fablab-bergamo/Fab-O-matic/hardware/README.md

# HARDWARE information (PCB, Enclosures)

This folder contains info about PCB (Gerber file, BOM, schematics) and enclosures.

## PCB versions

* Project has been sponsored by EasyEDA in the OpenHWLab [Project homepage](https://oshwlab.com/pascal.brunot/rfid-arduino-fablab-bg-v2_2024-04-01_14-22-11)
* For more information, a series of articles regarding the HW & PCB design have been published on our FabLab website (Italian language 🇮🇹)

> [Breadboarding](https://www.fablabbergamo.it/2024/06/03/fabomatic1/)
>
> [Modules and Box](https://www.fablabbergamo.it/2024/06/09/fabomatic2/)
>
> [PCB](https://www.fablabbergamo.it/2024/06/16/fabomatic3/)
>
> [Electrical schema](https://www.fablabbergamo.it/2024/06/23/fabomatic4/)
>
> [PCB-A and costs](https://www.fablabbergamo.it/2024/06/30/fabomatic5/)

### Revision 1.3

Changes from rev 1.2:

* Design is now robust for Mains voltage on PCB for machine control (large PCB copper tracks, isolation gaps > 4 mm, PCB cutout)
* Added D9 to protect USB from incorrect power flow to machine and host.
* 2 independent terminal blocks for machine control and board power
* Layout and routing changed, but ESP32/RFID/LCD/factory default button/Neopixel have not been moved.

⚠ Errata in this revision ⚠

* None known.

### Revision 1.2

Changes from rev 1.1:

* Added D7 and D8 for reverse voltage protection on 5V and POW+ external pins, also they prevent incorrect power flow to machine and host.
* Removed (wrong) over-voltage protection Zener diodes.
* Terminal block pin 8 is now left unconnected (previously, it was an output 3V3).
* Added R13/R14/R15 to tolerate 5V input if R16 is removed.
* (Color PCB) Added small vias on color PCB to allow the NeoPixel light to filter through.

⚠ Errata in this revision ⚠

* PCB design is not MAINS AC safe (see NC/NO/COM tracks: width, spacing and area copper plane & signal tracks).
* Any high current will BURN the COM/NO PCB tracks on the PCB from the terminal blocks to the relay. As a workaround, solder wires between terminal blocks and relay pins on the PCB !

### Revision 1.1

Changes from rev 1.0:

* Fixed buck converter R11 connection to FB pin instead of 5V.
* Fixed Q1 footprint (switched model)
* Buzzer is now on top side as it makes enough noise and it can be assembled by JLCPCB this way.
* Slight layout changes (moved connector down, protection components done, increased distance between relay and command components)

⚠ Errata in this revision ⚠

* PCB design is not MAINS AC safe (NC/NO/COM tracks to the relay).
* Any high current will BURN the COM/NO PCB tracks on the PCB from the terminal blocks to the relay. As a workaround, solder wires between terminal blocks and relay pins on the PCB !
* Power can flow from the machine to the host through the USB port. A diode needs to be added.
* Power can flow from the host to the machine through the USB port. A diode needs to be added.
* The color PCB front panel is missing a soldermask expansion to let the NeoPixel light filter through the white silkscreen. A small spot of silkscreen can easily be removed with a Dremel as fix.
* Reverse/under voltage protection circuit is wrong.

### Revision 1.0

This version is easy to order as pre-assembled on JLCPCB. For 10 boards, total cost (as per April 2024) is below 200 EUR total (not considering modules and boxes). Soldering map is available is you want to assemble yourself : <code>rev 1.0/soldering_map.html</code>

⚠ Errata in this revision ⚠

* PCB design is not MAINS AC safe (NC/NO/COM tracks to the relay).
* Any high current will BURN the COM/NO PCB tracks on the PCB from the terminal blocks to the relay. As a workaround, solder wires between terminal blocks and relay pins on the PCB !

* Q1 had wrong footprint, B and E pins are swapped. As a result, relay is not operative.

To fix: desolder Q1 and resolder it upside down with a good amount of soldering tin.

* Buck converter is delivering 0.8V instead of 5V due to schematic error.

To fix: R11 shall be connected between GND and FB pin, because FB shall be the center of the voltage divider. In this version, R11 was connected between GND and 5V.
This can be fixed by rotating R11 by 90° counter-clockwise and solder it to R9.

* The RFID pin labels printed on bottom side are wrong (text only issue).



* The color PCB front panel is missing a soldermask expansion to let the NeoPixel light filter through the white silkscreen. A spot of silkscreen can easily be removed with a Dremel.
* Power can flow from the machine to the host through the USB port. A diode needs to be added.
* Power can flow from the host to the machine through the USB port. A diode needs to be added.
* Reverse/under voltage protection circuit is wrong.

Changes from rev 0.4:

* Added an integrated a buck converter for 5V generation instead of a module
* Replaced USB B port with a USB C
* SMD components wherever possible (Q1, USB, variable resistor, buttons)
* Components update based on [https://github.com/yaqwsx/jlcparts] availabilities
* ESP32-S3-WROOM-1-N4R8 selected for availability (N4 was enough).
* More compact board design
* Added a color printer PCB front panel design + layout adjustments to accomodate front panel design

### Revision 0.4

Changes:

* Fixed errata of revision 0.3
* Removed 220u CAP after testing, it is not required.
* Moved the design to EASYEDA Pro (free) for future versions

⚠ Errata in this revision ⚠

* PCB design is problably not MAINS AC safe (NC/NO/COM tracks to the relay).
* Power can flow from the machine 5V to the host through the USB port. A diode needs to be added.
* Power can flow from the host to the machine 5V through the USB port. A diode needs to be added.

### Assembly instructions

An interactive PCB map is available under <code>rev 0.4/soldering_map.html</code>

Order is important:

1. (front side) Solder ESP32S3-WROOM-1 module. Check for shorts.
2. (front side) Solder all others SMD components
3. (front side) Solder through-hole components (terminal blocks, relay, Q1, USB, capacitor)
4. (reverse side) Solder NeoPixel, 3V buzzer, female pins for RFID / LCD modules, defaults switch.

Test procedure

1. Continuity check : power lines (3V3, 5V) to ESP32, LDO, LCD/RFID modules.
2. Terminal blocks: NC and COM shall be continuous. NO and COM shall not be continuous.
3. Check for shorts between 5V and - ; 3V3 and - ; + and - pins (there should not be any)
4. Connect +5V to the 5V terminal block and GND to - terminal block
5. Check that voltage on 3V3 pin is 3.3V
6. Disconnect external power.
7. Connect USB cable to PC
8. Check voltages on 5V and 3V3 pins
9. Push BOOT, Push RESET, Release RESET, release BOOT
10. ESP32S3 shall be recognized on PC as a serial port

💡 A fresh ESP32-S3 will be in a reboot cycle before the first flash. It is normal to have the USB connect/disconnect sounds at this stage.

11. Upload software with PlatformIO
12. Disconnect USB
13. Connect modules (including buck converter if needed)
14. Connect USB
15. Open Monitor and check for errors.

### Revision 0.3

⚠ Errata in this revision ⚠

* PCB design is problably not MAINS AC safe (NC/NO/COM tracks to the relay).
* Q1 base shall be pulled up by a 5-10kohm resistor to 3V3 to avoid relay flickering at boot (while ESP32 has not pulled up the pin yet).

Changes:

* fixed errata of REV 0.2 (2N3906 for through hole/smd + RW pin)
* smaller footprints for capacitors
* added component values on silkscreen
* slight repositioning of RFID module to avoid overlap with default switch
* added 220 uF capacitor on 5V rail for LCD
* removed terminal blocks IN+/OUT+ as there are enough connection ports on the board
* added input protections with Zener+resettable 100mA fuses.

Link to project: <https://oshwlab.com/pascal.brunot/rfid-arduino-fablab-bg_copy>

### Revision 0.2

Fully working with some issues requiring rework.

Assembled front:



Assembled back:



⚠ Errata in this revision ⚠

* Relay requires more current than ESP32 can provide. A PNP transistor can be soldered next to the terminal blocks to solve the problem. Connect Base on K pin, Emitter on 3V3 pin and Collector to coil (+). The track between CMD and Coil(+) passing below the relay must be cut. Relay takes 70 mA approx. The pin must be configured active_low.



* (NOT IN THE PHOTO) : a 10k resistor shall be added too between Base and 3V3 to avoid flickering at boot. Fixed in rev 0.4.

* Buzzer must be 3V3 low current. However common Arduino buzzers require 5V and high current. When using this model, the ESP32 resets due to voltage dropping. There are two solutions: use a 3 pin Arduino buzzer with VIN/GND/Signal (the PCB is compatible with such buzzers), or use a low current buzzer.

* LCD RW pin must be grounded (fix with soldering wire). Otherwise the LCD does not accept commands from ESP32.



Changes during assembly:

* Variable resistor for brightness adjustment replaced with 1k resistor
* C2 and C3 were not mounted because their pads were damaged during ESP32 soldering.
* Zener protection diode D7 and F1 not mounted (overvoltage protection)
* D4 replaced with a wire (reverse polarity protection) because voltage drop was too high (need 0.3V)

## 3D enclosures

## For hardware revision 1.x

* A Freecad project is provided in "enclosure for rev 1.x" folder. The finished 3D printed enclosure result is shown below:





* Enclosure concept



* How to print ?

2 STL files are provided (CASE and TAPPO) to import in your preferred slicer.

* How to assemble ?

4 screws, washer and bolts are required to fix the PCB to the case.

Assembly photos see <https://github.com/fablab-bergamo/Fab-O-matic/tree/b52aab18b81a9b51205c8e2c9dcc90458335382c/hardware/enclosure%20for%20rev%201.x/photos>
