fablab-bergamo/Fab-O-matic/hardware/enclosure for rev 1.x/freecad-case.gif

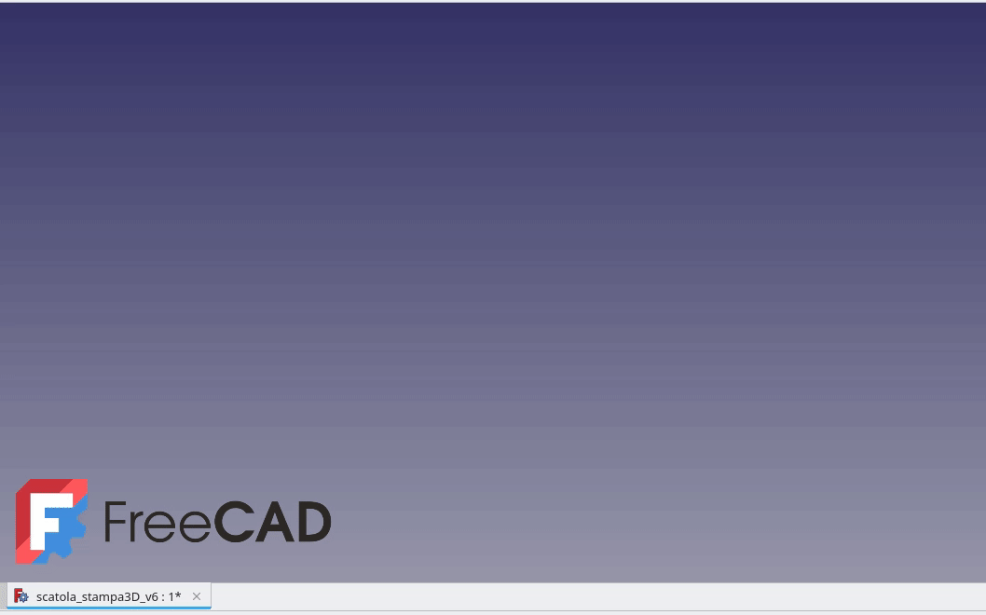
hardware/enclosure for rev 1.x/freecad-case.gif
