fablab-bergamo/Fab-O-matic/hardware/enclosure for rev 1.x/photos/IMG_20240713_195248.jpg

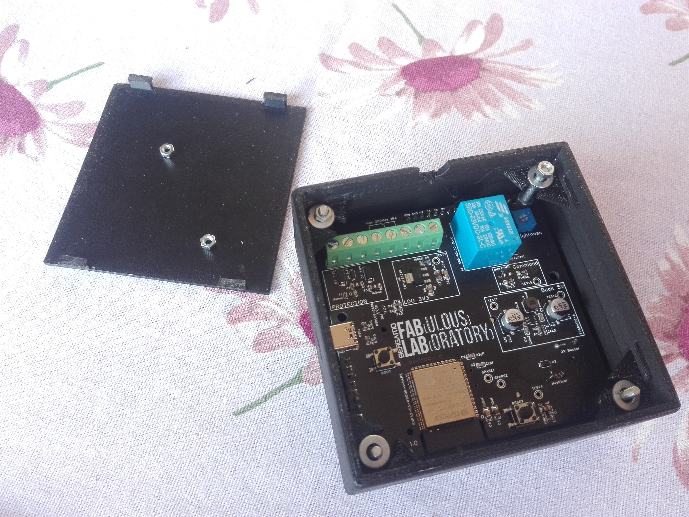
hardware/enclosure for rev 1.x/photos/IMG_20240713_195248.jpg
