fablab-bergamo/Fab-O-matic/hardware/rev 1.3/3D_PCB REV1.3_2024-08-18.png

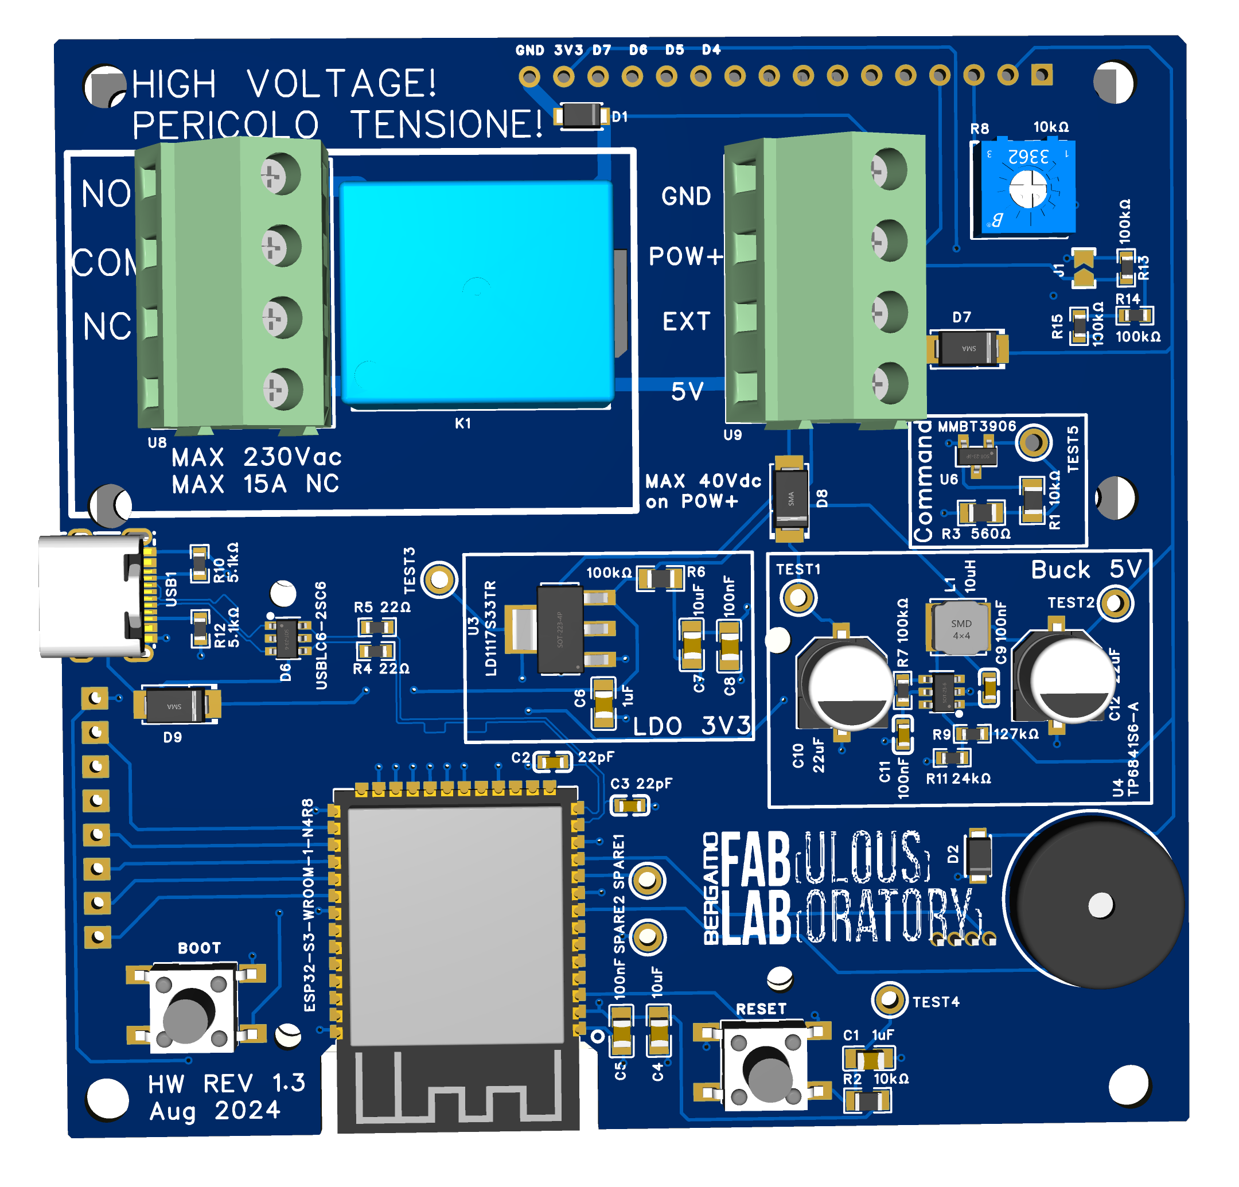
hardware/rev 1.3/3D_PCB REV1.3_2024-08-18.png
