fablab-bergamo/Fab-O-matic/hardware/rev 1.3/prices no shipping.png

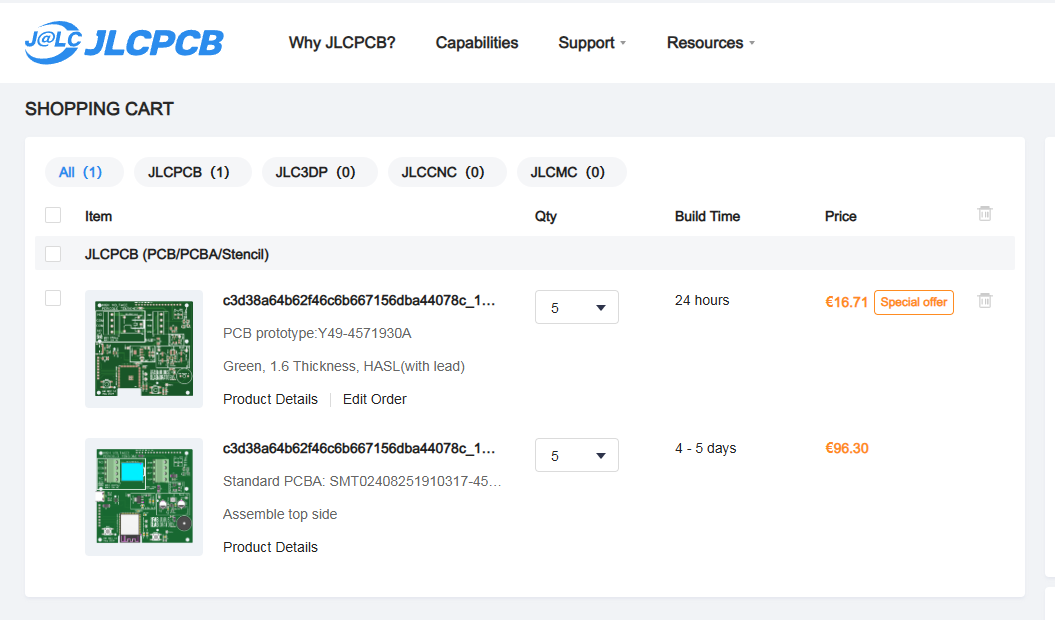
hardware/rev 1.3/prices no shipping.png
