fablab-bergamo/Fab-O-matic/hardware/rev 1.3/track width.png

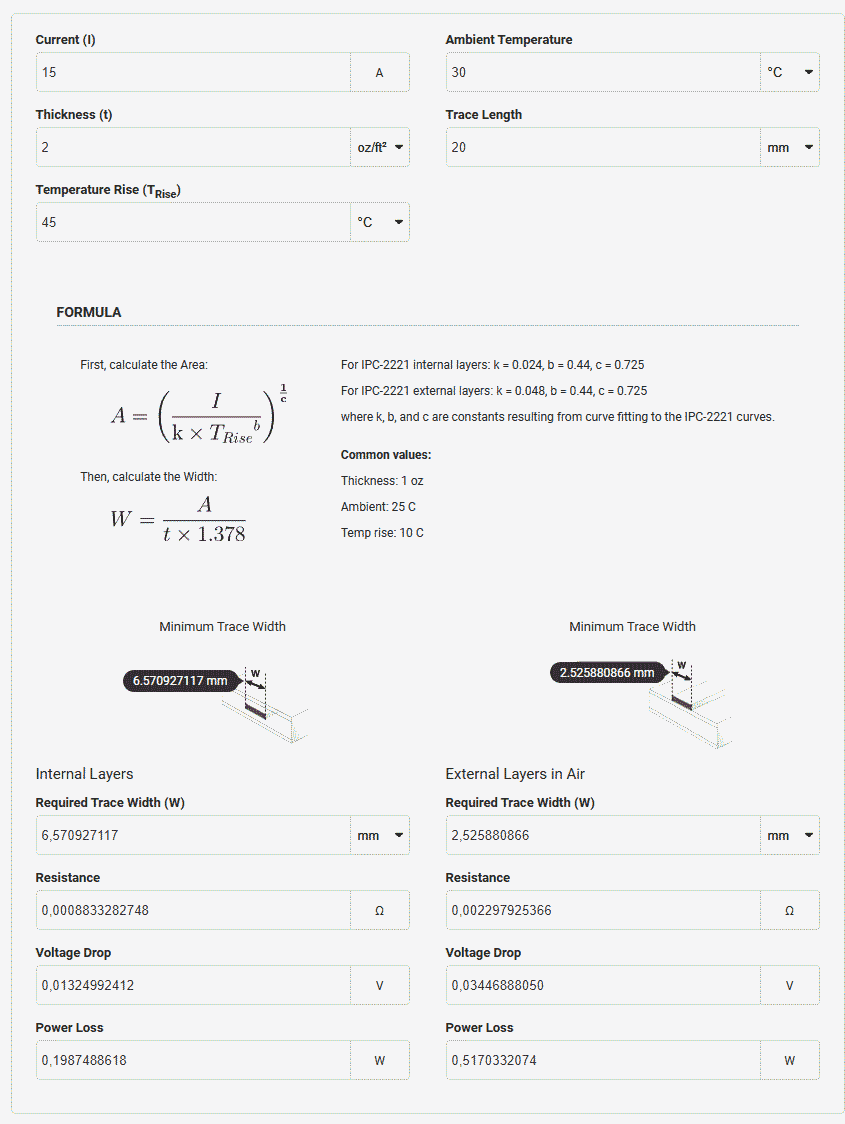
hardware/rev 1.3/track width.png
