fablab-bergamo/Fab-O-matic/hardware/rev 1.3/BOM_FAB-O-MATIC_PCB REV1.3_2024-08-18.xlsx

No. | Quantity | Comment | Designator | Footprint | Value | Manufacturer Part | Manufacturer | Supplier Part | Supplier
1 | 1 | 4kHz | BUZZER1 | BUZ-TH_BD12.5-P6.50-D0.9 | 4kHz | SFN-12055PA6.5 | S&S(海旭) | C360607 | LCSC
2 | 2 | 1uF | C1,C6 | C0805 | 1uF | CL21B105KBFNNNE | SAMSUNG(三星) | C28323 | LCSC
3 | 2 | 22pF | C2,C3 | C0603 | 22pF | CL10C220JB8NNNC | SAMSUNG(三星) | C1653 | LCSC
4 | 2 | 10uF | C4,C7 | C0805 | 10uF | GRM21BR61H106KE43L | muRata(村田) | C440198 | LCSC
5 | 2 | 100nF | C5,C8 | C0805 | 100nF | CL21B104KCFNNNE | SAMSUNG(三星) | C28233 | LCSC
6 | 2 | 100nF | C9,C11 | C0603 | 100nF | CC0603KRX7R9BB104 | YAGEO(国巨) | C14663 | LCSC
7 | 2 | 22uF | C10,C12 | CAP-SMD_BD6.3-L6.6-W6.6-FD | 22uF | RVT22UF50V67RV0028 | KNSCHA(科尼盛) | C2836438 | LCSC
8 | 2 | SM4007PL | D1,D2 | SOD-123F_L2.8-W1.8-LS3.7-RD |  | SM4007PL | MDD | C64898 | LCSC
9 | 1 | USBLC6-2SC6 | D6 | SOT-23-6_L2.9-W1.6-P0.95-LS2.8-BL |  | USBLC6-2SC6 | TECH PUBLIC(台舟) | C2827654 | LCSC
10 | 3 | SS34 | D7,D8,D9 | SMA_L4.3-W2.6-LS5.2-RD |  | SS34 | MDD | C8678 | LCSC
11 | 3 | Jumper | J1,J2,J3 | JUMPER
12 | 1 | SRD-03VDC-SL-C | K1 | RELAY-TH_SRD-03VDC-SL-C |  | SRD-03VDC-SL-C | 松乐 | C496430 | LCSC
13 | 3 | TSA063G60-250 | KEY1,KEY2,KEY3 | KEY-SMD_4P-L6.1-W6.1-P4.50-LS9.0 |  | TSA063G60-250 | BRIGHT(博瑞泰) | C294566 | LCSC
14 | 1 | 10uH | L1 | IND-SMD_L4.0-W4.0 | 10uH | SWPA4030S100MT | Sunlord(顺络) | C38117 | LCSC
15 | 1 | WS2812D-F5 | LED1 | LED-TH_4P-BD5.8-P1.30 |  | WS2812D-F5 | worldsemi | C190565 | LCSC
16 | 1 | RFID | P1 | footprint_17af |  | Female headerHDR1X8-2.54 | BOOMELE | C27438 | LCSC
17 | 2 | 10kΩ | R1,R2 | R0805 | 10kΩ | 0805W8F1002T5E | UNI-ROYAL(厚声) | C17414 | LCSC
18 | 1 | 560Ω | R3 | R0805 | 560Ω | 0805W8F5600T5E | UNI-ROYAL(厚声) | C28636 | LCSC
19 | 1 | 100kΩ | R6 | R0805 | 100kΩ | 0805W8F1003T5E | UNI-ROYAL(厚声) | C149504 | LCSC
20 | 4 | 100kΩ | R7,R13,R14,R15 | R0603 | 100kΩ | 0603WAF1003T5E | UNI-ROYAL(厚声) | C25803 | LCSC
21 | 1 | 10kΩ | R8 | RES-ADJ-TH_3362P | 10kΩ | 3362P-1-103 | BOCHEN(博晨) | C118956 | LCSC
22 | 1 | 127kΩ | R9 | R0603 | 127kΩ | RC0603FR-07127KL | YAGEO(国巨) | C245905 | LCSC
23 | 2 | 5.1kΩ | R10,R12 | R0603 | 5.1kΩ | 0603WAF5101T5E | UNI-ROYAL(厚声) | C23186 | LCSC
24 | 1 | 24kΩ | R11 | R0603 | 24kΩ | 0603WAF2402T5E | UNI-ROYAL(厚声) | C23352 | LCSC
25 | 1 | ESP32-S3-WROOM-1-N4R8 | U1 | wirelm-smd_esp32-s3-wroom-1 |  | ESP32-S3-WROOM-1-N4R8 | ESPRESSIF(乐鑫) | C2913200 | LCSC
26 | 1 | LD1117S33TR | U3 | SOT-223_L6.5-W3.5-P2.30-LS7.0-BR |  | LD1117S33TR | ST(意法半导体) | C86781 | LCSC
27 | 1 | TP6841S6-A | U4 | SOT-23-6_L2.9-W1.6-P0.95-LS2.8-BL |  | TP6841S6-A | TECH PUBLIC(台舟) | C2844924 | LCSC
28 | 1 | LCD-1602 | U5 | footprint_8a57 |  | ?
29 | 1 | MMBT3906 | U6 | SOT-23-3_L2.9-W1.3-P1.90-LS2.4-BR |  | MMBT3906 | 宏迦橙 | C7420354 | LCSC
30 | 2 | DB103-5.0-4P-GN-S | U8,U9 | CONN-TH_4P-P5.00_DB103-5.0-4P-GN-S |  | DB103-5.0-4P-GN-S | DORABO(地博电气) | C430585 | LCSC
31 | 1 | U262-161N-4BVC11 | USB1 | USB-3.1-SMD_U262-161N-4BVC11 |  | U262-161N-4BVC11 | XKB Connectivity(中国星坤) | C319148 | LCSC
