fablab-bergamo/Fab-O-matic/hardware/rev 1.0/Wrong footprint - C7420354 component.pdf

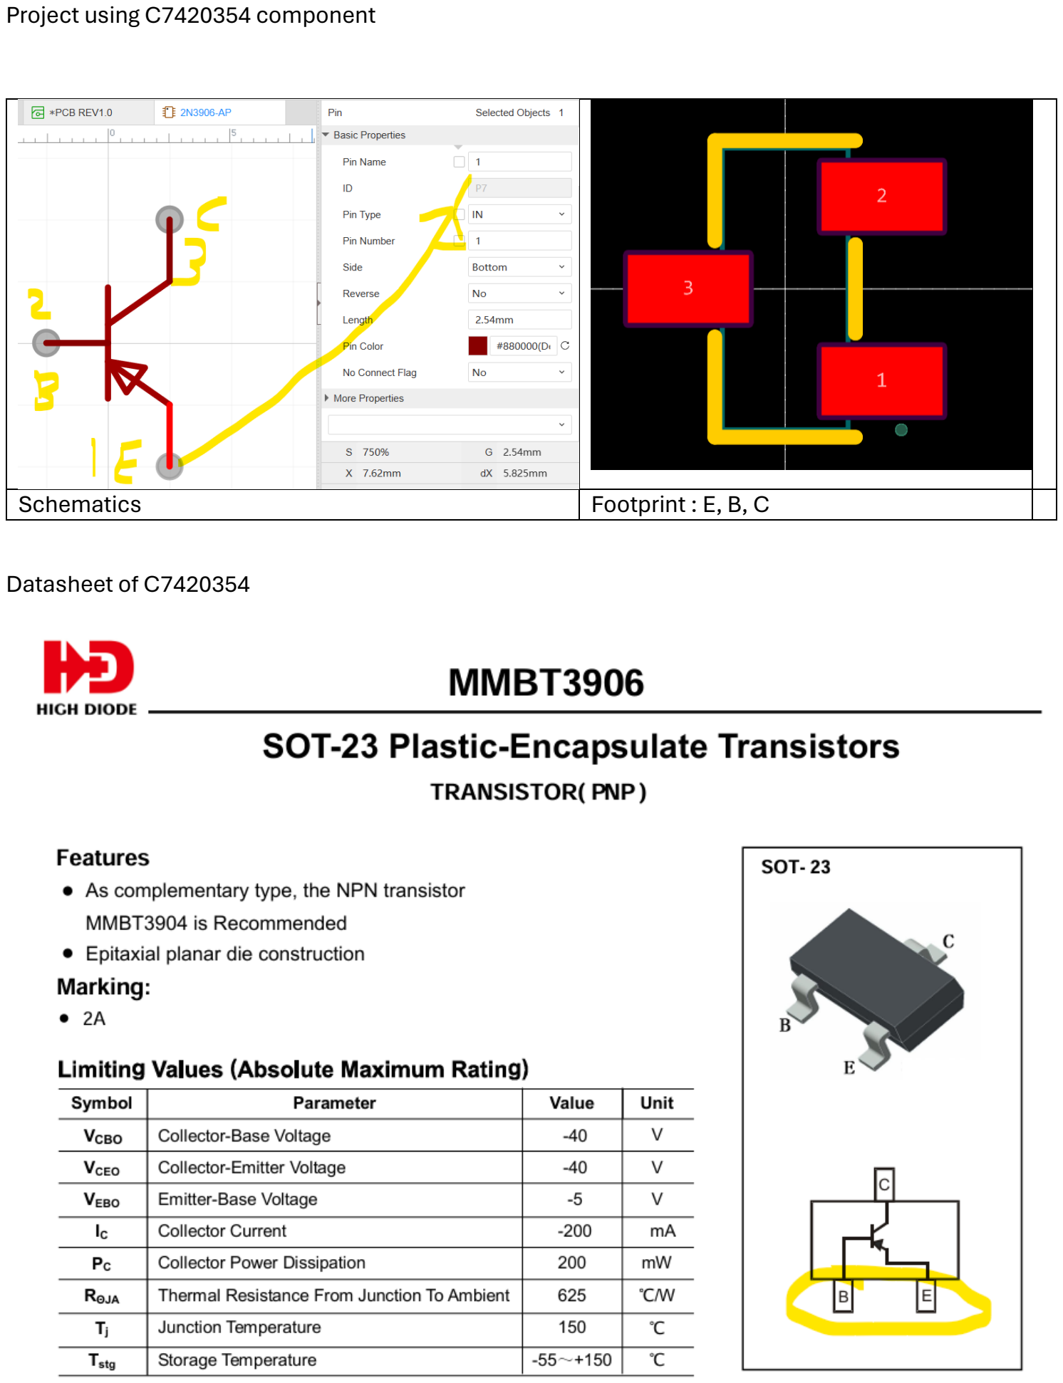
[picture p14: page 1]

Project using C7420354 component

Schematics | Footprint : E, B, C

Datasheet of C7420354
