fablab-bergamo/Fab-O-matic/hardware/enclosure for rev 1.x/scatola_stampa3D_v6.FCStd

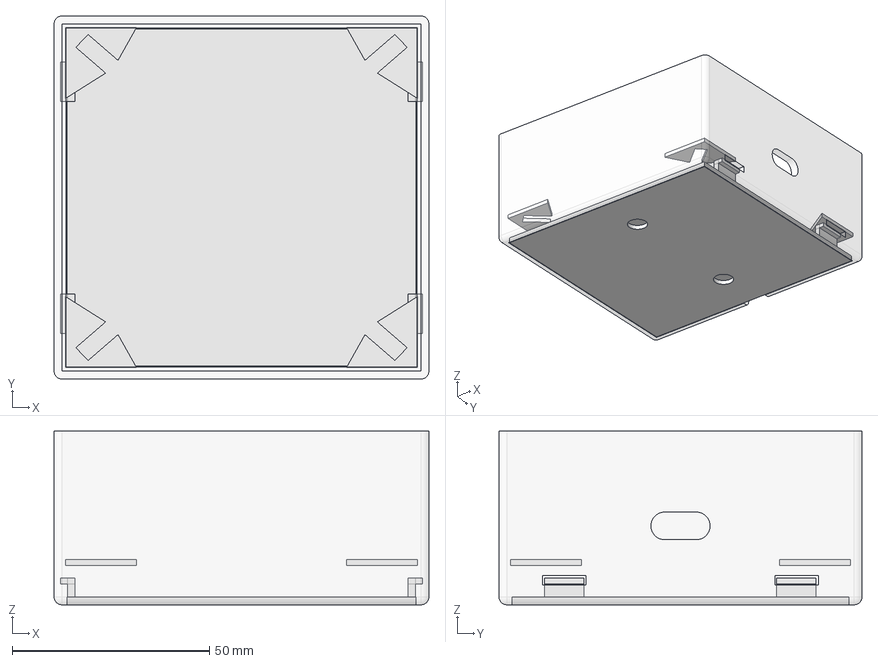
[picture p15: CAD file, 2024-07-20]
hardware/enclosure for rev 1.x/scatola_stampa3D_v6.FCStd
95.0 x 92.0 x 44.0 mm
Corpo
gancio-primi-due
ganci-x4
fondo-piatto
fermi-per-viti
