fablab-bergamo/Fab-O-matic/hardware/enclosure for rev 1.x/scatola_stampa3D_v6_CASE.stl

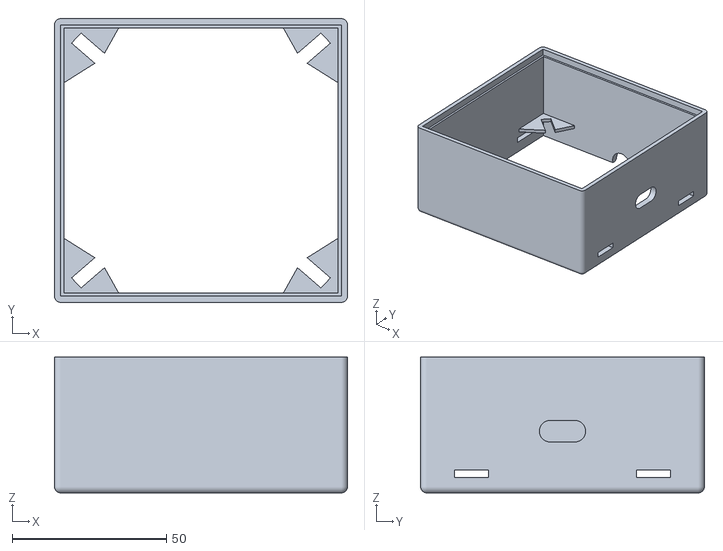
[picture p16: CAD file, 2024-07-20]
hardware/enclosure for rev 1.x/scatola_stampa3D_v6_CASE.stl
95.0 x 92.0 x 44.0
