fablab-bergamo/Fab-O-matic/hardware/enclosure for rev 1.x/scatola_stampa3D_v6_TAPPO.stl

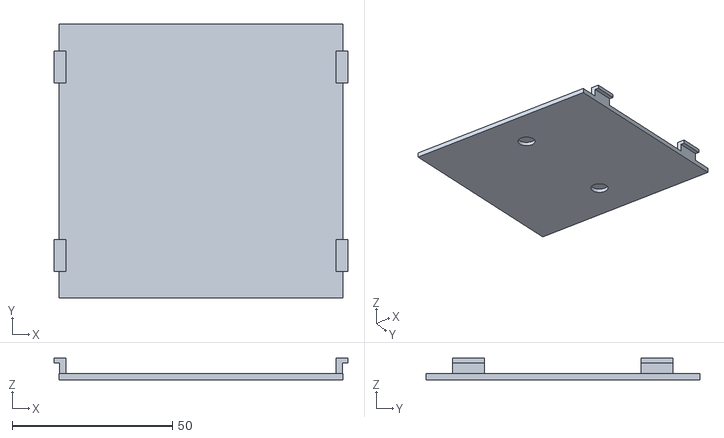
[picture p17: CAD file, 2024-07-20]
hardware/enclosure for rev 1.x/scatola_stampa3D_v6_TAPPO.stl
91.8 x 85.5 x 6.80
