fablab-bergamo/Fab-O-matic/hardware/enclosure for rev 0.x/fabomatic hw rev0 taglio laser.dxf

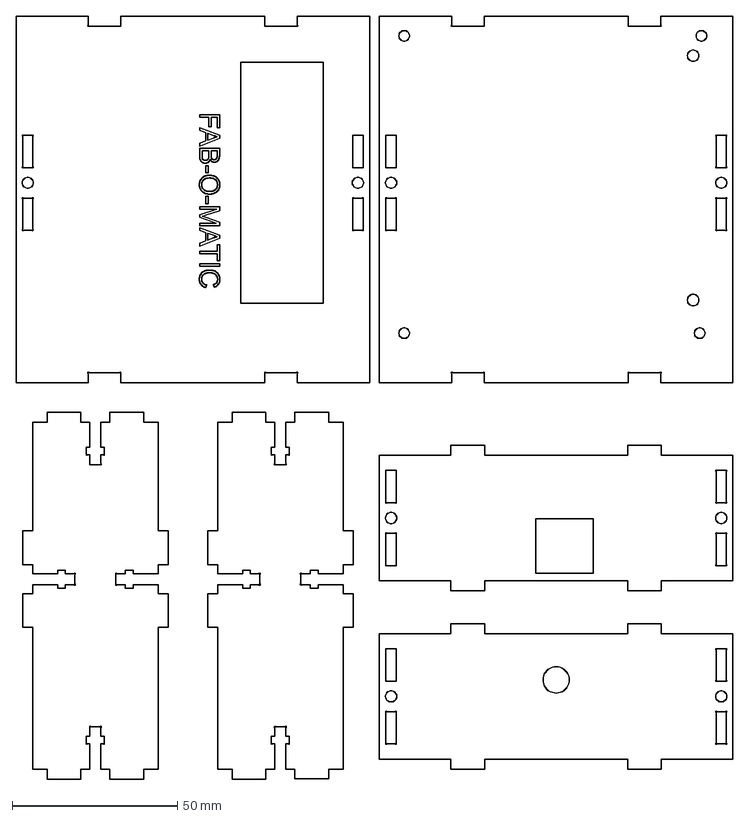
[picture p18: CAD file, 2024-08-16, an earlier design]
hardware/enclosure for rev 0.x/fabomatic hw rev0 taglio laser.dxf
217.0 x 231.1 mm
