fablab-bergamo/Fab-O-matic/hardware/equipment_wiring/Documentazione modifiche macchine FABOMATIC.pdf

# CNC GP010

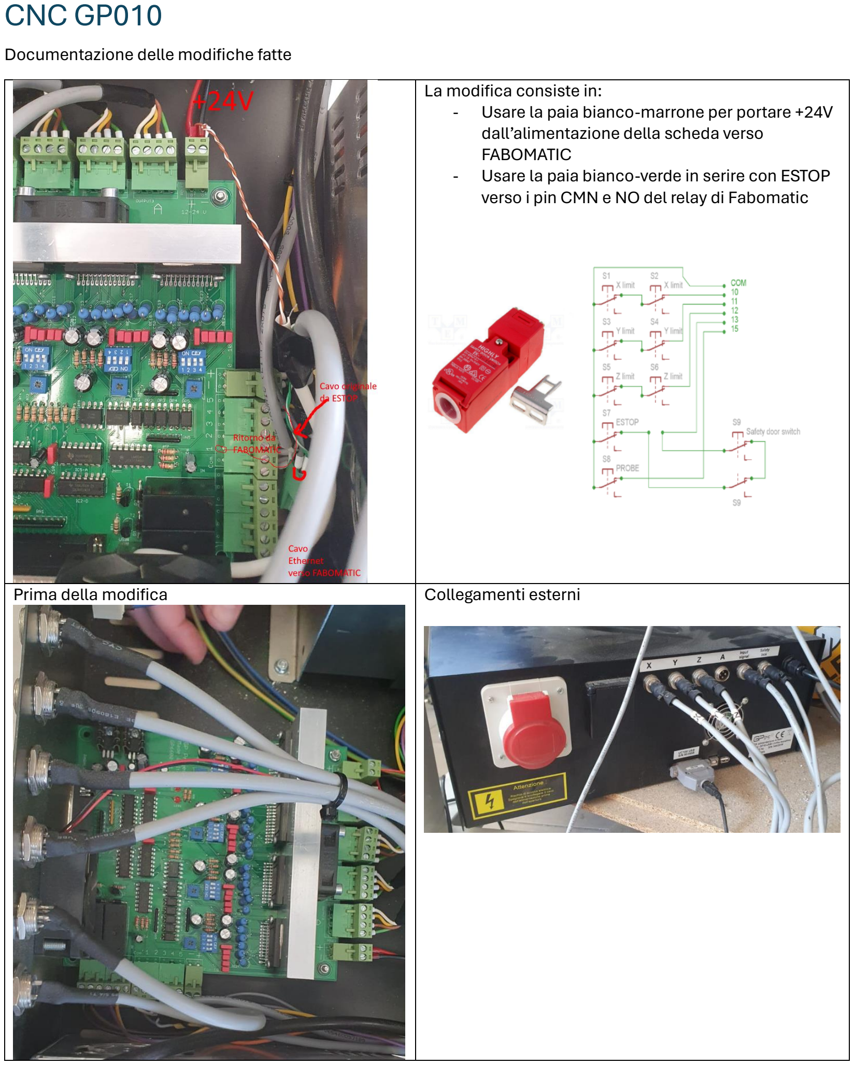
[picture p19: page 1]

Documentazione delle modifiche fatte La modifica consiste in:
- Usare la paia bianco-marrone per portare +24V dall’alimentazione della scheda verso FABOMATIC
- Usare la paia bianco-verde in serire con ESTOP verso i pin CMN e NO del relay di Fabomatic
Prima della modifica | Collegamenti esterni

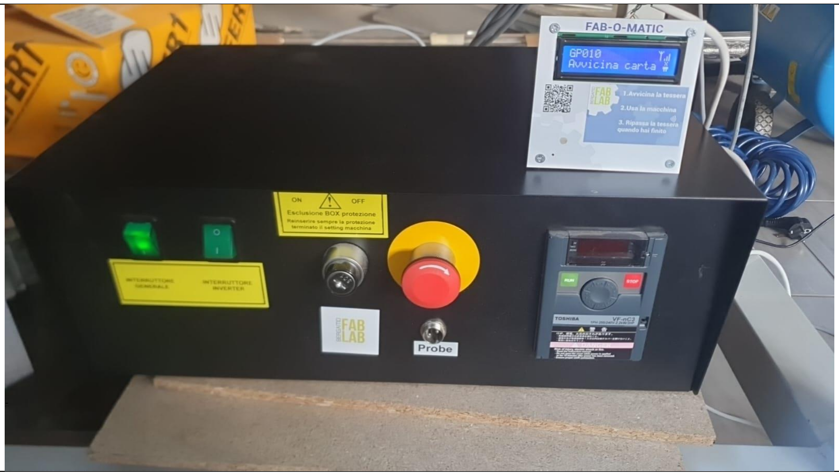
[picture p20: figure]

Risultato finale

# Laser REDSAIL

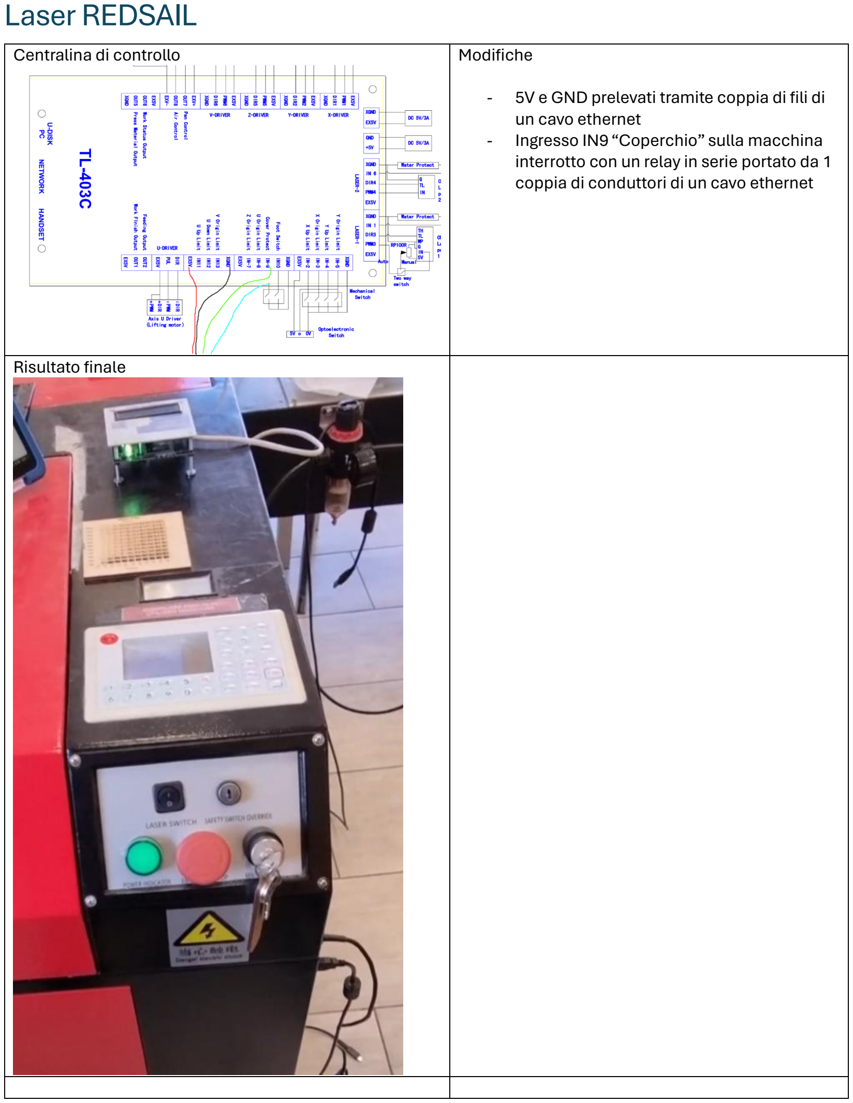
[picture p21: page 3]

Centralina di controllo | Modifiche
- 5V e GND prelevati tramite coppia di fili di
| un cavo ethernet
- Ingresso IN9 “Coperchio” sulla macchina
| interrotto con un relay in serie portato da 1 coppia di conduttori di un cavo ethernet

Risultato finale

# Stampanti ENDER

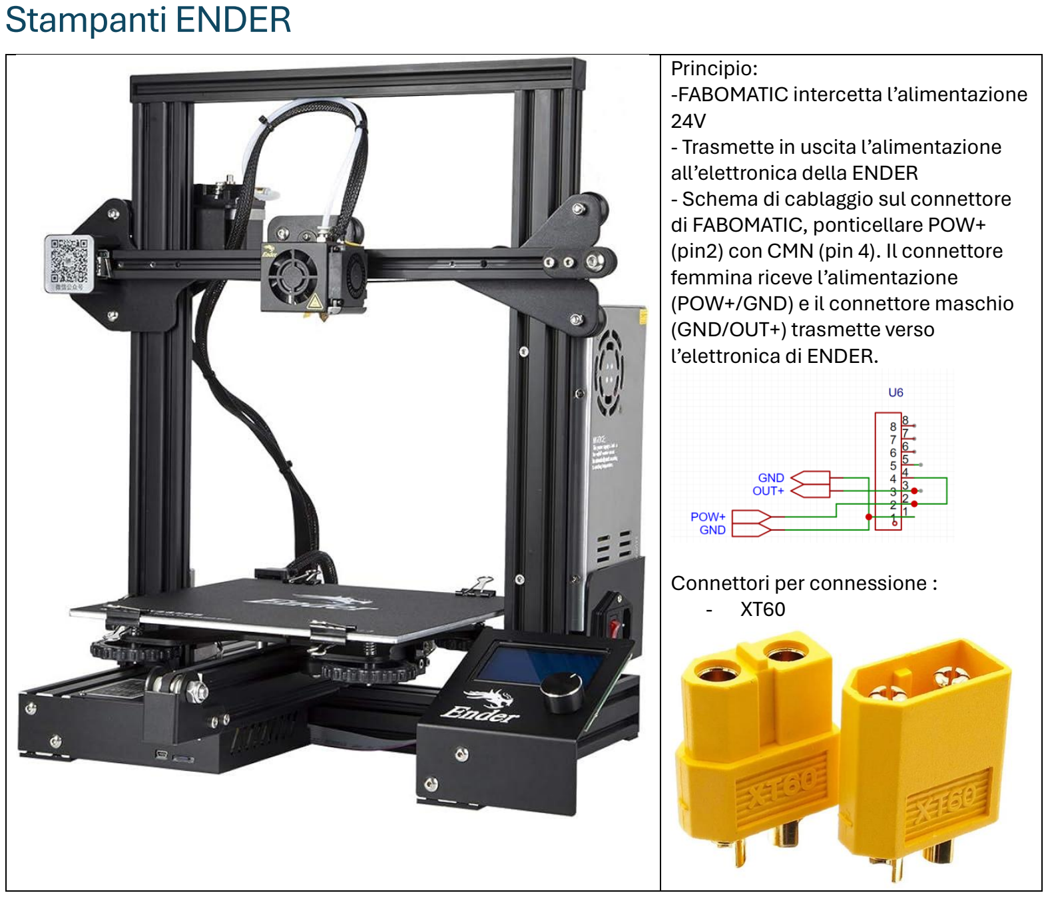
[picture p22: page 4]

Principio:
-FABOMATIC intercetta l’alimentazione 24V
- Trasmette in uscita l’alimentazione all’elettronica della ENDER
- Schema di cablaggio sul connettore di FABOMATIC, ponticellare POW+ (pin2) con CMN (pin 4). Il connettore femmina riceve l’alimentazione (POW+/GND) e il connettore maschio (GND/OUT+) trasmette verso l’elettronica di ENDER.

Connettori per connessione :
- XT60
