fablab-bergamo/Fab-O-matic/(threads)

Thread 4 (2023-04-11):

V1.0 Requirements discussion

PBrunot, 2023-04-11:
I'm opening an issue to gather feedback regarding requirements identified for the RFID lab machine management. I use English as the end-goal may be to integrate such a solution in Fab Manager.

### Requirements for V1.0 (can be revised):

#### Functional requirements

- Board must *enable usage* of lab machines by users, based on individual RFID tags
- Board must be *easy to use* with no user training requirements (usage in a school context)
- Board must be *robust* in case of WiFi issues, to avoid blocking the lab or powering off machines it network is out of service
- Board must be low-maintenance for Fab Lab (ideally only initial setup and no batteries)
- Board must physically fit next to the machines
- Board must not interfere with long jobs (e.g. printing large 3D pieces)
- Cumulative hours *Machine usage* must be registered for maintenance
- Board must signal that *machine maintenance* is needed (e.g. laser lens cleaning every X hours)
- A FabLab user can register *maintenance operations* to reset the maintenance signal
- Server must be able to handle several boards simultaneously (min. 10 boards)
- A FabLab admin must be able to *ENABLE/DISABLE machine* for general usage
- Server must provide *statistics per machine* (usage log, hours cumulated, maintenance done)

#### Regulatory requiments

- *GDPR compliance* based on fab member consent or anomized data.
- Boards must be *electrically safe* for usage in public space.

#### Economical requirements

- Boards must be *low cost* to manufacture (criteria < 50 eur/board)
- Server must be *low cost* to operate (criteria < 50 eur/year)

#### Excluded requirements for V1.0 (can be revised)

- Access control (boards control machines, not doors).
- Server shall not depend on Fab Manager (this can be done later, and it requires some plugin because the FabManager data model is not ready : no hours per machine, no maintenance, no attribute for users to link to tags, non-Fab users in the lab...)
- Server shall not handle users abilitation to machines (this feature can come with the Fab Manager integration)
- Board shall not track consumables (e.g. meters of filament acquisition)
- Board shall not track actual machine **running** time (it will rely on user log-on and log-off)

### Design choices so far

- Board must control power of the machine (230Vac) or provide a volt-free contact (e.g. EN signal to machine board)
- To avoid user interaction on board, one machine per board is supported.
- Basic architecture ```(Machine) <-1-connected to-1-> (Board) <-n-connected-to-1-> (Server)```
- Board has microprocessor, 16x2 LCD, RFID reader, buzzer, WiFi and bluetooth connection.

valerionew, 2023-04-11:
Thanks Pascal, looks good!

I can add a few points, mostly from a staff member perspective:
- Maintenance performed checks should be performed by a staff member before the user is allowed to use the machine. This could conflict with the board controlling machine power, as power may be required for maintenance (e.g. mirror align on laser cutters, moving the CNC axes for cleaning etc.). I'm thinking of asking for a staff member's card to activate the machine for maintenance. We could add the option to postpone maintenance, but should we really? I'm thinking of a short tap with a staff member's card to postpone by a power cycle vs a hold for three seconds for start maintenance.
- We don't strictly need to get the system on printed circuit boards that are manufactured. We could do with a kit made of commercial modules, at least for the first version of the system (the one that we will deploy at first).

Also, where should we put the requirements for the server? Here there is a first old draft of the specs: https://github.com/fablab-bergamo/rfid-database-interface/blob/main/README.md

Here there is also a rough TODO list: https://github.com/fablab-bergamo/rfid-database-interface/blob/main/TODO.md

PBrunot, 2023-04-22:
@valerionew :
I've added the maintenance performed to the boards (it's in the open PR #3 ).
When the machine requires maintenance, usage is blocked.
A short tap from a fablab admin will enable the machine anyways (so postponing maintenance is not required).
A long tap (3s) will register the maintenance operation as done.

Regarding PCB: most of the standard parts are in the lab, no problem.
What is your idea for machine connection ? I'm not sure we can do safely interrupt a powerline with standard parts on a breadboard... I'm not an EE engineer, but it would required case-assembly-soldering of parts-fixtures before we connect mains wires ?... Also, I think the lab machines do not have an "external enable" signal to bring a volt-free signal from the relay.
Maybe we could add in serie the relay to a safety interlock.

Finally regarding server requirements I have opened a separate issue in fablab-bergamo/rfid-database .

valerionew, 2023-04-22:
Probably breaking the interlock chain is the safest, I agree with you. But while the lasers and CNCs have that, there is no interlock in 3D printers. One strategy would be operating the reset pin of the control boards, but that is not always obvious to find and to "hack into", plus it requires some modifications to the board itself that can invalidate warranty.

My idea was indeed to interrupt the power line. In 3D printers we could safely and easily do it on the low voltage line. So the user would still have to turn on the machine via the usual switch, and then the box would prompt the user for a card, closing the low voltage circuit.

Another discussion we have to do is powering. If we intercept any power, such as in 3D printers, we can exploit that. But if we don't, like with the lasers and the CNCs, how do we power the box?

Last big thing on this point, we should forecast the possibility of a system that we cannot modify at all (even with non-permanent modifications). In that case, the only option would be to interrupt the power cable.

valerionew, 2023-04-29:
@PBrunot If it is ok with you, I would like to give you write access to this repo, so you can work directly on a branch of this repo instead of a fork.

valerionew, 2023-04-29:
I've also created a [project](https://github.com/orgs/fablab-bergamo/projects/3) in the organization's page to help us keep track of the various ongoing feature developments.

I don't know if this is going to be useful, if not just leave it be and we will delete it.

[Projects documentation on github](https://docs.github.com/en/issues/planning-and-tracking-with-projects)

PBrunot, 2023-04-29:
Nice, I've never used projects but it looks like a better option than using issues to keep tracks of things to do.
I've created a few tasks in it.

PBrunot, 2024-06-09:
### Review of Requirements as of June 2024

#### Functional requirements
| Requirement | Status | notes |
| -- | -- | -- |
| Board must *enable usage* of lab machines by users, based on individual RFID tags | ✅ | - |
| Board must be *easy to use* with no user training requirements (usage in a school context) | ✅ | QRCode and LCD |
| Board must be *robust* in case of WiFi issues, to avoid blocking the lab or powering off machines it network is out of service  | ✅ | Caching of RFID+whitelist to allow usage |
| Board must be low-maintenance for Fab Lab (ideally only initial setup and no batteries) |✅ | Powered by the machine itself |
| Board must physically fit next to the machines | ✅ | approx 10x10x6 cm  |
| Board must not interfere with long jobs (e.g. printing large 3D pieces) |  ✅ | Autologoff can be disabled |
| Cumulative hours *Machine usage* must be registered for maintenance | ❌ | Some bugs to be fixed |
| Board must signal that *machine maintenance* is needed (e.g. laser lens cleaning every X hours) | ✅ | LCD displays expired maintenance text |
| A FabLab user can register *maintenance operations* to reset the maintenance signal | ✅ | Done with long tap |
| Server must be able to handle several boards simultaneously (min. 10 boards)  |  ✅ | Tested with 5,6 so far without issues |
| A FabLab admin must be able to *ENABLE/DISABLE machine* for general usage |  ✅ | "Blocked for all" in backend project |
| Server must provide *statistics per machine* (usage log, hours cumulated, maintenance done) |  ✅ | See backend project |

#### Regulatory requiments

| Requirement | Status | notes |
| -- | -- | -- |
| *GDPR compliance* based on fab member consent or anomized data.  |  ❌ | Purge and GDPR consent to be reviewed |
| Boards must be *electrically safe* for usage in public space.  |  ✅ | So far only 24VDC is used |

#### Economical requirements

| Requirement | Status | notes |
| -- | -- | -- |
| Boards must be *low cost* to manufacture (criteria < 50 eur/board)  | ✅ | approx 15eur/board |
|  Server must be *low cost* to operate (criteria < 50 eur/year) |  ✅ | runs on Raspberry Pi or DebianVM |

#### Excluded requirements for V1.0 (can be revised)

| Requirement | Status |
| -- | -- |
| Access control (boards control machines, not doors). |  ❌ not planned |
| Server shall not depend on Fab Manager (this can be done later, and it requires some plugin because the FabManager data model is not ready : no hours per machine, no maintenance, no attribute for users to link to tags, non-Fab users in the lab...) | not started |
| Server shall not handle users abilitation to machines (this feature can come with the Fab Manager integration) | ✅ actually this has been done in the backend as optional step for critical machines |
| Board shall not track consumables (e.g. meters of filament acquisition) | ❌ not planned |
| Board shall not track actual machine **running** time (it will rely on user log-on and log-off) | 💡could be done with external signal |

PBrunot, 2024-11-30:
Completed version 1.0

Closed 2024-11-30.

Thread 5 (2023-04-22):

Technological choices

PBrunot, 2023-04-22:
The current implementation has an MQTT client only with MongoDB database. There is no MQTT broker for the  boards to connect.  In my opinion a"self-contained" python server with minimal external dependencies could be desiderable.

Protocols for the boards, options I see:
- MQTT Broker : [amqtt](https://github.com/Yakifo/amqtt)
- REST API sserer : https://flask.palletsprojects.com/en/2.2.x/ (to stay in line with FabManager architecture)

For database, options I see :
- MongoDB (current code base)
- PostgreSQL (to keep alignment with FabManager)
- SQLite (to get rid of independent DB engine, simplicity of development/installation)

My personal preference would be API REST + SQLite.

valerionew, 2023-04-22:
I don't have any opinion on this. We may ask @lorossi and @MauroMombelli perhaps if they have anything to add

PBrunot, 2023-04-28:
ok so for MQTT the libraries will be :
- esp32/adrduino : 256dpi/MQTT (MIT license). Client-side implemented and tested with mosquitto broker. It seems to work fine (so far). See https://github.com/fablab-bergamo/rfid-arduino/issues/6

- python server side on Raspberry Pi : I will use [amqtt](https://github.com/Yakifo/amqtt) (MIT License)

valerionew, 2023-04-29:
Why did you pick these two libraries instead of the more common [PubSubClient](https://github.com/knolleary/pubsubclient) for esp32 and [mosquitto](https://github.com/eclipse/mosquitto) for the server side?

The choice is fine, I'm just wondering if there is any reason to not use the two most widespread libraries/softwares

PBrunot, 2023-04-29:
I actually used mosquitto on PC to test the ESP32 client library, it is easy to use. But I was hoping to have only one python program (without external programs) for server side, using Python libraries for Database, web server, MQTT broker. But maybe that's a wrong approach. I don't know if it's easy to "bundle & configure" things in Raspberry Pi.

For ESP32, I picked 256dpi/MQTT because it seems actively maintained (PubSubClient last commit is 3 years ago) and it was available in platformio repository. Licenses are the same (MIT). I can easily change to PubSubClient if this is a more common choice.

PBrunot, 2023-05-01:
Now that I have a Raspberry Pi Zero, I understand better the approach. Mosquitto is running fine on Raspberry and I will use it as broker.

Closed 2023-05-01.

Thread 6 (2023-04-26):

MQTT diagrams

PBrunot, 2023-04-26:
I took advantage of 25th April and implemented the following logic in Arduino. To exchange structured data between backend and board over MQTT I used JSON strings (code is not in the Pull Request yet but in pbrunot/rfid-arduino mqtt branch).
I tried to keep the spirit of the original fablab-bergamo/rfid-database implementation, but I did not really understand why a token is important (MQTT server can handle authentication with user/password or certificates). Also, I think it's the board job, not the backend job, to manage the machine "free/not free" status (because we need to work in offline scenarios and the board commands the machine power).

To try to be as clear as I possible I created diagrams of the main scenario. I can also provide schemas for maintenance logic, failed authentication, ... if desired. Sequencediagram.org is quite easy to use

* Board init
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

* Online access
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

* Offline access
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

Please comment if I am going in the right direction.

valerionew, 2023-04-29:
>  Also, I think it's the board job, not the backend job, to manage the machine "free/not free" status (because we need to work in offline scenarios and the board commands the machine power).

I second this. The only reason this is concerning the server is the work hours. But this is handled by the start use/stop use.

PBrunot, 2023-06-23:
To solve the electrical safety problem the following device is being tested : https://lamiacasaelettrica.com/shelly-plus-1/
In this case the ESP32 will publish MQTT messages to power on or off the machine (or break/close the interlock chain) ; the shelly device has a MQTT client which seems to work well.

This device makes machine integration a lot simpler.
It also creates the problem that the board may not be in sync with the device status, unlike with a relay. My approach will be to check periodically the shelly device status and emit a command from ESP32 if it's different from expected.

valerionew, 2023-06-23:
So this solution would be to add a second device other than the controller, to power on and off the machine?

Thread 8 (2023-06-23):

Long tap is too fast

PBrunot, 2023-06-23:
Long tap is required when the machine needs maintenance and the fab lab staff wants to register the performed maintenance on the machine.

While testing on ESP32S3 it was observed that the long tap takes milliseconds to be completed, there's a bug in the waiting routine.

PBrunot, 2024-01-01:
fixed in commit 0845c33

Closed 2024-01-01.

Thread 9 (2023-12-26):

Allow configuration of SSID & Password without flashing the firmware

PBrunot, 2023-12-26:
Once in a box usb port of ESP32 may not be easily accessible. Right now the configuration is in secrets.h as compile-time constants, so recompile+flash is needed.

Ideas to solve the probem:
- Expose a Bluetooth device and allow writes to bluetooth characteristics with app like nRF connect.
- Starting of soft AP with a web management interface (slow and not secured, no https). Not sure if it can run parallel with the rest of the system.

Requires
- persistent storage on esp32 flash

To be investigated
- if bluetooth can be secured
- if there are good soft AP + webserver libraries (maintained). Probably not with https though...
- there is no physical user interface except the RFID tags (e.g. no config button to be held in boot-time). So probably the config interface shall be present all the time.

valerionew, 2023-12-26:
This works amazing, we've tested it before:

https://github.com/tzapu/WiFiManager

PBrunot, 2023-12-26:
Thanks, this library looks perfect indeed. I will try it soon.

PBrunot, 2023-12-29:
Completed.

When WiFi configuration fails at *boot-time*, the WiFi AP and portal is activated. ON LCD Screen, the IP address of the portal is shown. The AP name will be "ESP xxxxxx" depending on chip id.

When WiFi fails during runtime, the board will try to reconnect to MQTT broker every 30s with saved settings. There is no automatic portal launch in this case, because it may be a temporary AP failure.

LCD example:
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

I tested with a real esp32s2 and a mobile phone. The web portal allows the user to perform following configuration:
- WiFi SSID and password (mandatory)
- Machine ID (mandatory)
- MQTT Broker server (mandatory)
- MQTT Switch topic (for shelly , disabled if empty)

Configuration is saved in EEPROM on successfully AP join.

Configuration Portal has a timeout after a few minutes.

- In this degraded mode without AP configuration, the connected machine shall still be usable (provided the RFID whitelist and default configuration are fine in the board), but clearly the usage tracking will be lost.

Closed 2023-12-29.

Thread 12 (2024-03-16):

Save cached UID in EEPROM from time to time ?

PBrunot, 2024-03-16:
When the WiFi network is down, the whitelist is used to check for users RFID card to allow machine usage.
Right now the whitelist is hard-coded in secrets\conf.hpp, requiring recompilation and update to change the whitelist.

Probably the whitelist should be merged with a cache of latest authorized users and saved in EEPROM like other config settings.

This would make the system more robust when the network goes down.

PBrunot, 2024-04-15:
First this is no EEPROM on ESP32, only Flash memory which is used by Arduino EEPROM class. It seems to work for small size only.

I have added a cache of last 10 RFID cards with the following logic:
- cache is saved every 2 minutes (if there are changes vs. previous version) to reduce Flash memory wear
- at boot time cache is reloaded
- cache is updated when the server accepts (or refuse) an RFID card
- cache contains user rfid card and user level, the name has not been saved to reduce memory usage

When the server cannot be reached (only in this case) the cache is searched and if the card is found, user is logged in with previous user level. In case the cache fails to find the card ID, then the whitelist is still searched, cache and whitelist are kept as two different concepts.

In terms of implementation, the cache has been added to the SavedConfig class and testcases have been extended to validate this. std::array have been used to ensure static allocation of cache, some stack warnings have appeared because SavedConfig is now quite a large object. However we still have plently of RAM so I didnt optimize.

See PR #13  + following commits for bugfixes.

Closed 2024-04-15.

Thread 14 (2024-04-22):

OFFLINE scenario - recording actual use ?

PBrunot, 2024-04-22:
Machines needs to be operated even in OFFLINE scenario. For example, 3D printers may be brought out of the lab for temporary events. Or WiFi may go down.

Currently, the machine remains usable with RFID cards provided that:
1- the user card is in whitelist
2- the user card is in cache (last 10 successfull authentications)

It is possible to instruct users to authenticate on the machine before moving the machine out of the lab so that we are sure that the cache is up to date.

However, the usage data in OFFLINE scenario will be lost.

Possible solution:
- memorize (user card id; duration in sec) in flash memory and, when reconnected to the backend, transmit the data.
- Timestamp will be the time of reconnection, as actual usage datetime is lost (as ESP32 does not have an RTC).

Notes for possible implementation:
- user may power off the machine without logging out, destroying the information. A similar workaround to the one used in ONLINE scenario (i.e. sending inUse message with duration so that the backend can properly close the orphan usage record) is needed. E.g. duration needs to be saved regularly in flash every X minutes.
- space for emulated EEPROM in Arduino on default partition table is limited / not sure we can support two persisted classes. Workaround: Custom partition table / SPIFFS file system may be needed (complexity). On the other hand we only need 12 bytes per event.
- backend already handles "missed" startUse events, so sending "endUse" message with the right duration is enough (simple)
- adding a new dedicated mqtt message (offlineUse with card uid + duration). This would allow the UI to flag the usage record as offline.
- upon connection to MQTT server enumerate persisted messages in flash, and upon successfully playback, delete it.

PBrunot, 2024-05-25:
Another use case is bad WiFi coverage in the lab.
We can miss events if the network is down at the wrong time. Impact will be limited but still the machine dashboard may show a machine busy for a long time after use.

PBrunot, 2024-06-09:
Done from version 0.9
Testcases added.

Closed 2024-06-09.

Thread 29 (2024-05-25):

Use EXT terminal block for laser duration recording ?

PBrunot, 2024-05-25:
It could be useful in the future to record the actual time a machine is running (e.g. laser ON...) vs. time it is in used.
Laser machines in the lab have an output for laser running which could be connected to it.

Not sure if this is really useful for maintenance

Maybe the board should include a resistor divider to handle 5V signals on the EXT with high values R.

Thread 32 (2024-06-01):

When shutdown is imminent, BEEPs should be emitted

PBrunot, 2024-06-01:
It seems Fabomatic is not beeping in this scenario, whereas it beeps correctly at boot time.

Investigate and create a test case.

PBrunot, 2024-06-08:
Tested in lab successfully

Closed 2024-06-08.

Thread 42 (2024-09-04):

Improve security

PBrunot, 2024-09-04:
MRFC522 chip and Arduino library use only chip ID of card for authentication. Anyways, current cards support MIFARE Classic algorithm, which is broken.  Therefore, the current level of security of the solution is low, especially against technically-savy users in a FabLab environment.

Improvements can be done but will require substantial efforts:
- member cards need to be updated with more robust chips
- MRFC522 chip needs to be replaced with PN532 or similar
- cryptography library is needed (one implementation is available in MitteFab : https://git.mittelab.org/proj/keycard-access )

PBrunot, 2024-09-07:
More details for MIFARE DESFire card implementation here : https://wiki.mittelab.org/progetti/keycardaccess

Thread 43 (2024-09-07):

Use an external SSR for power control

PBrunot, 2024-09-07:
When integrating FabOMatic on power lines for FabLab equipment, large DC currents may be involved.

E.g. a Zortrax M200 24V output power supply is 13.4A max.
E.g. an Ender3 24V ouput power supply is 15 A max

PCB in HW REV 1.3 improves somewhat the situation with larger tracks and isolation, but this is still not fully satisfying.
It is possible to solder wires on the PCB to improve current carrying capabilities and avoid burning the tracks.

A more robust solution could be to use an external solid-state relay with 25A rating with screws for connection.

Topics to be handled:
- Connections from board to SSR command in addition to on-board relay ?
- Make a modular design with relay or SSR ?
- Power dissipation of SSR (??)
- Fixtures inside FabOMatic 3D case for SSR
- Space/Isolation requirements

May be missing in FabLab:
- Wiring ferrules
- DC-DC SSR / AC-DC SSR
