fablab-bergamo/Fab-O-matic/hardware/rev 1.3/SCHEMATICS rev1.3.pdf

BUTTONS | 3V3

### MACHINE CONTROL

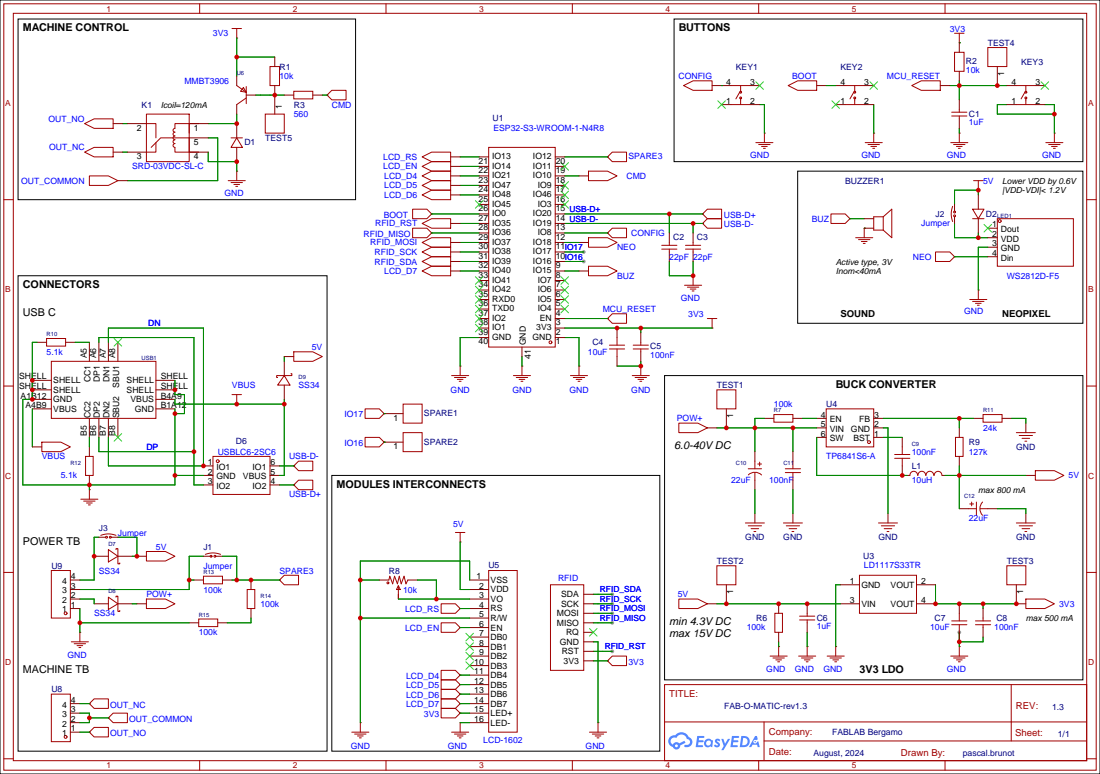
[picture p23: page 1]

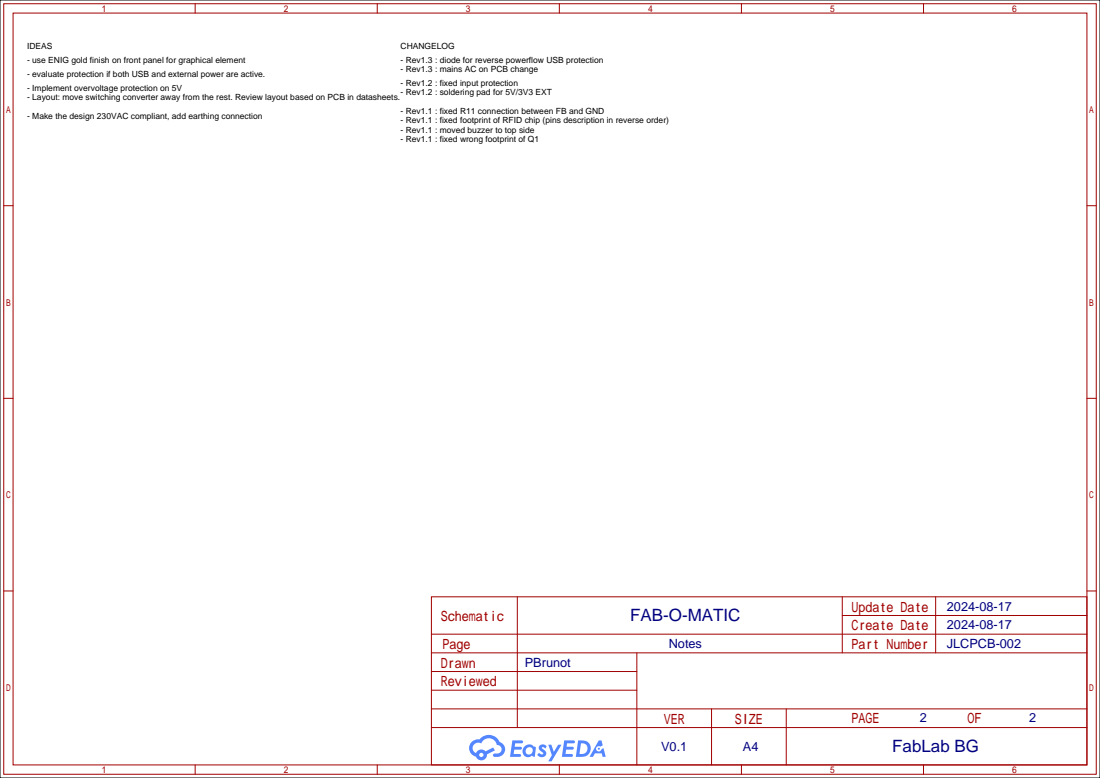
[picture p24: page 2]

- use ENIG gold finish on front panel for graphical element
- evaluate protection if both USB and external power are active.
- Rev1.2 : soldering pad for 5V/3V3 EXT - Implement overvoltage protection on 5V
- Layout: move switching converter away from the rest. Review layout based on PCB in datasheets.
- Make the design 230VAC compliant, add earthing connection

- Rev1.3 : diode for reverse powerflow USB protection
- Rev1.3 : mains AC on PCB change
- Rev1.2 : fixed input protection

- Rev1.1 : fixed R11 connection between FB and GND
- Rev1.1 : fixed footprint of RFID chip (pins description in reverse order)
- Rev1.1 : moved buzzer to top side
- Rev1.1 : fixed wrong footprint of Q1
