fablab-bergamo/Fab-O-matic/hardware/enclosure for rev 0.x/fabomatic hw rev0 taglio laser.pdf

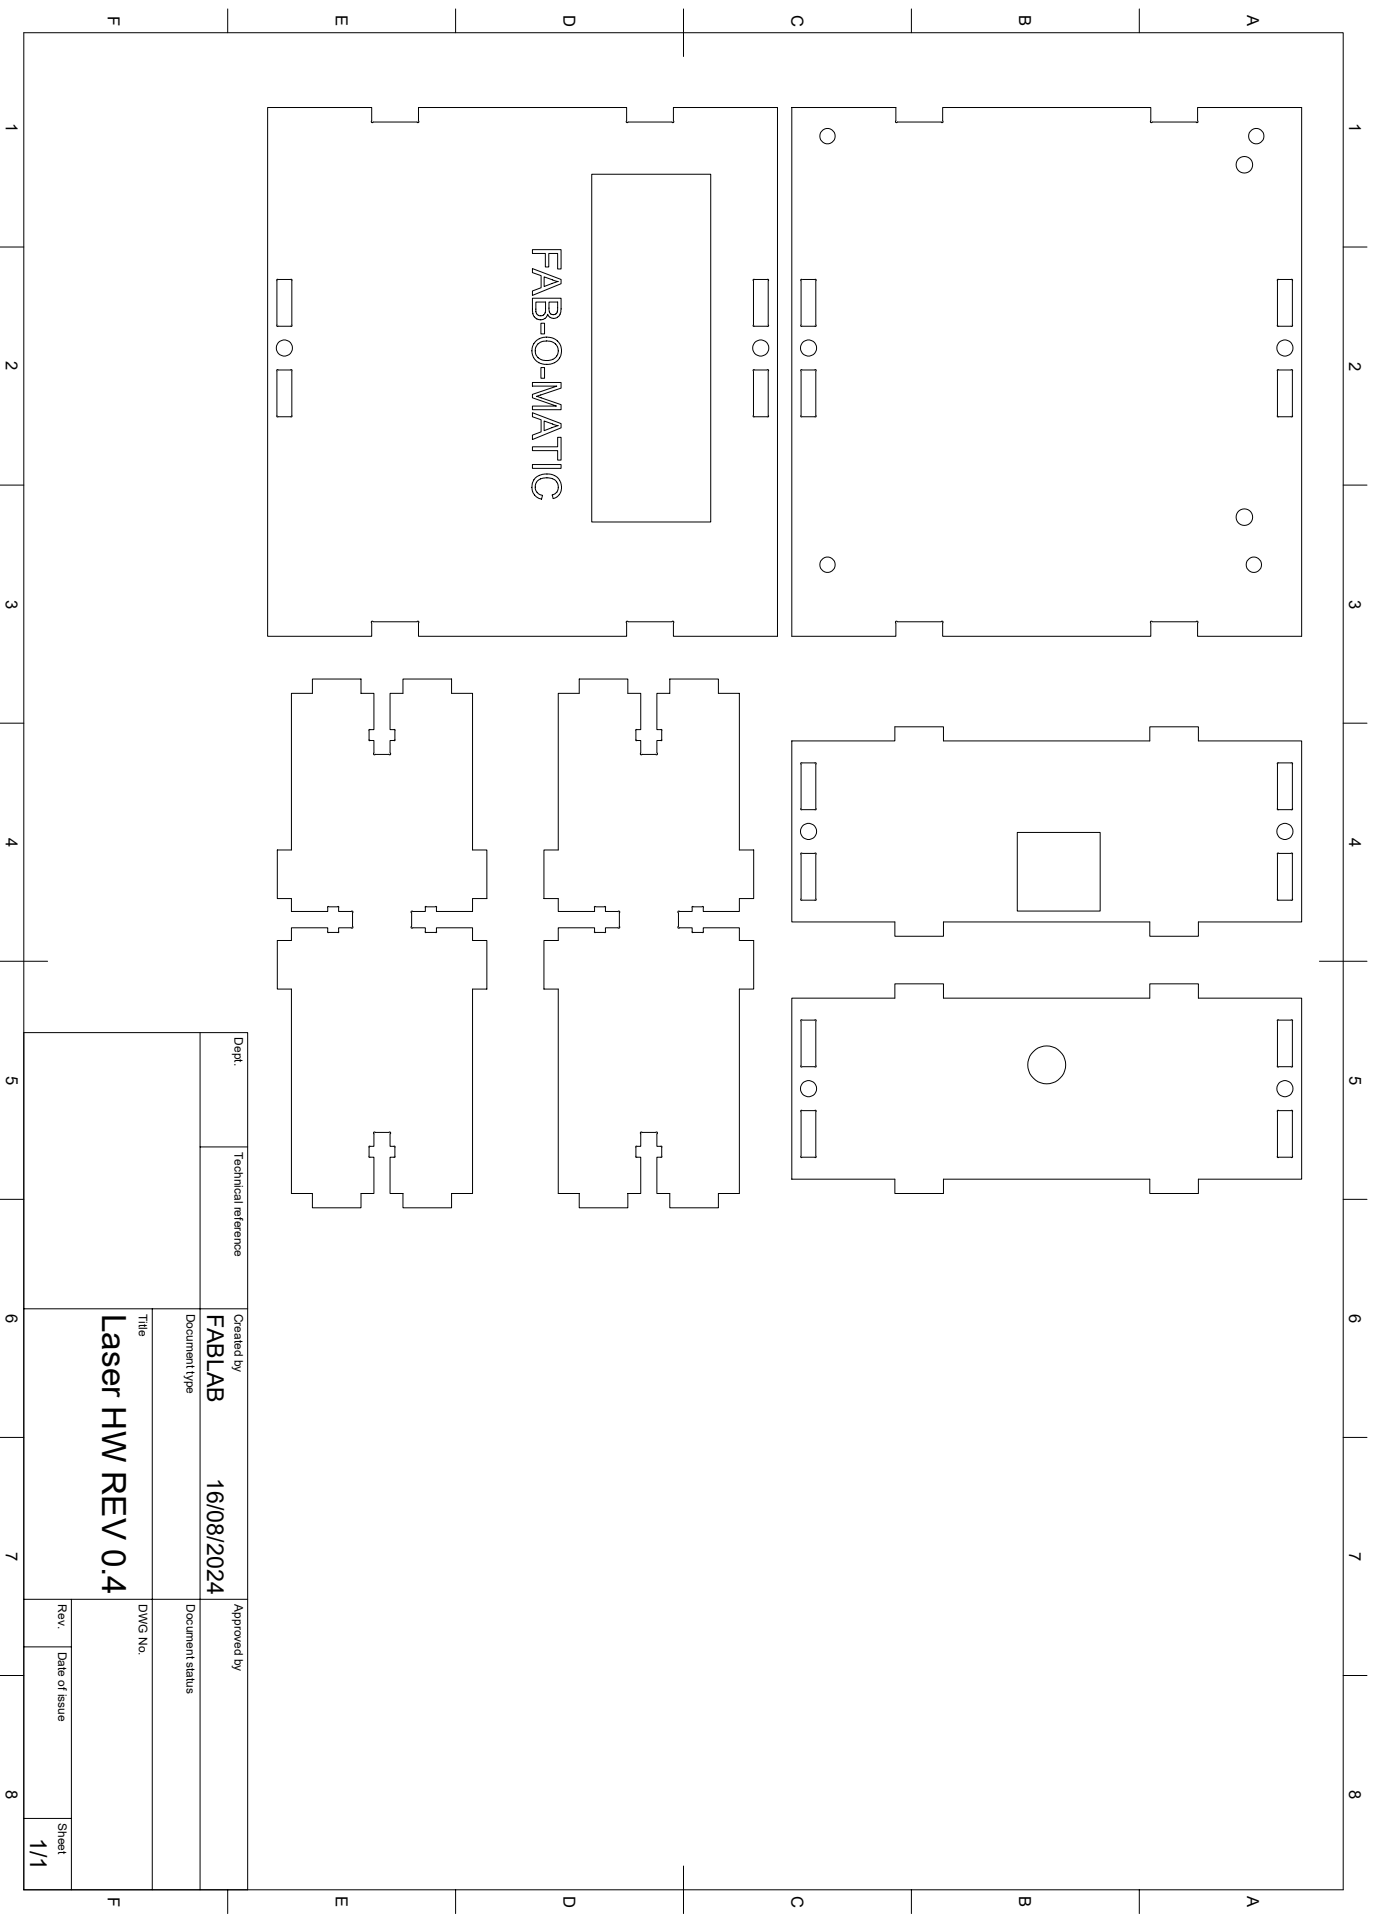
[picture p25: page 1]

Dept. Technical reference Created by Approved by Title DWG No. Document type Document status Rev. Date of issue Sheet 16/08/2024 1/1 Laser HW REV 0.4 FABLAB 1 A 2 3 4 5 6 7 8 1 2 3 4 5 6 7 8 FEDCB FEDCBA
