fablab-bergamo/Fab-O-matic/hardware/rev 1.2/SCH_FAB-O-MATIC_2024-06-24.pdf

### BUTTONS

### MACHINE CONTROL

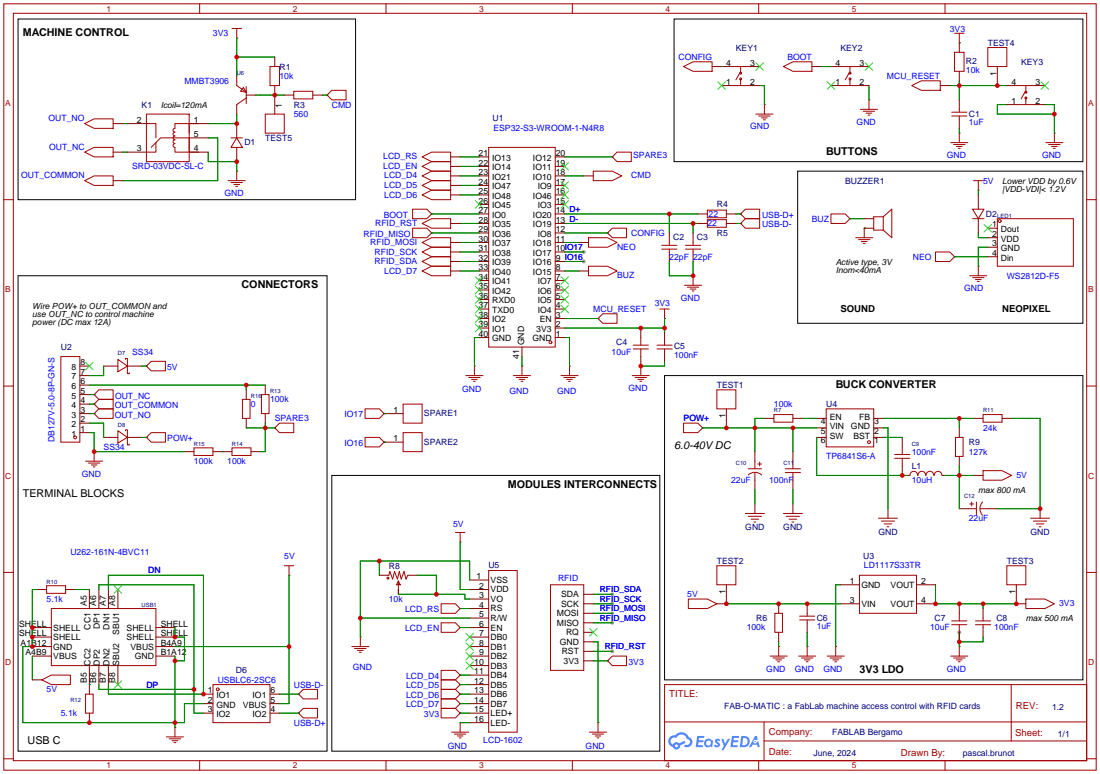
[picture p26: page 1]

Wire POW+ to OUT_COMMON and
use OUT_NC to control machine
power (DC max 12A)

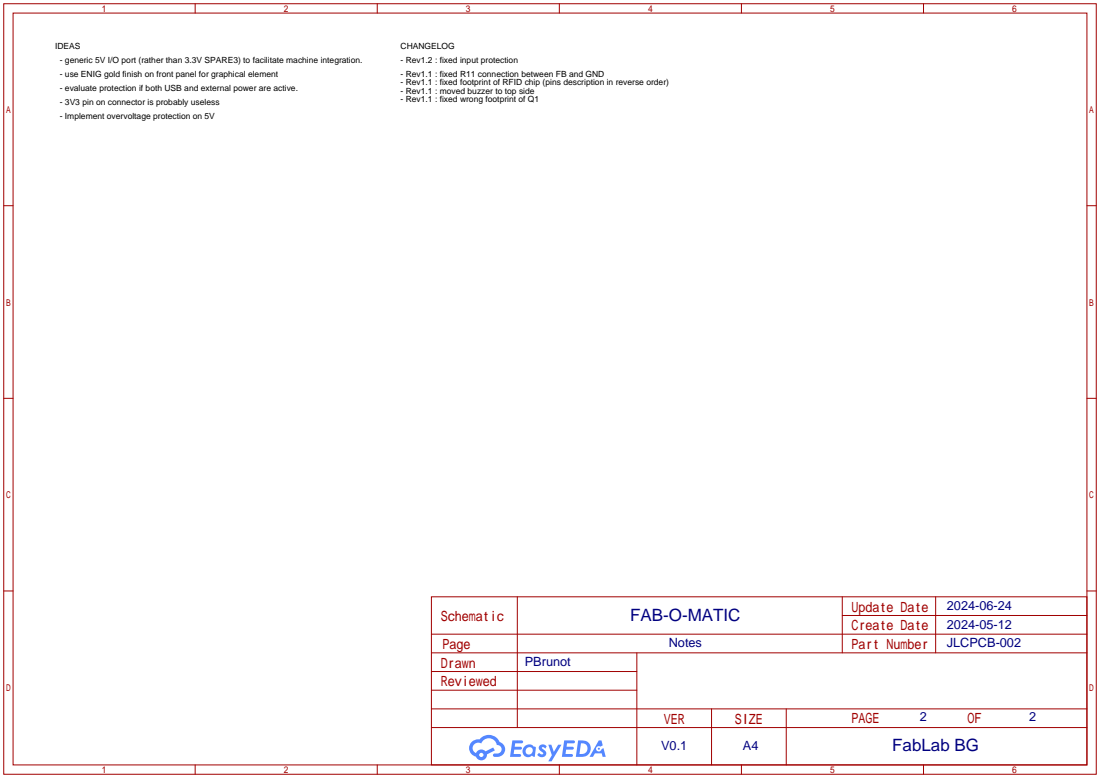
[picture p27: page 2]

- generic 5V I/O port (rather than 3.3V SPARE3) to facilitate machine integration.
- use ENIG gold finish on front panel for graphical element
- evaluate protection if both USB and external power are active.
- 3V3 pin on connector is probably useless
- Implement overvoltage protection on 5V

- Rev1.2 : fixed input protection
- Rev1.1 : fixed R11 connection between FB and GND
- Rev1.1 : fixed footprint of RFID chip (pins description in reverse order)
- Rev1.1 : moved buzzer to top side
- Rev1.1 : fixed wrong footprint of Q1
