fablab-bergamo/Fab-O-matic/hardware/rev 1.0/pcb rev1.0.pdf

## 3V3 5V EXT NC COM NO IN+ GND

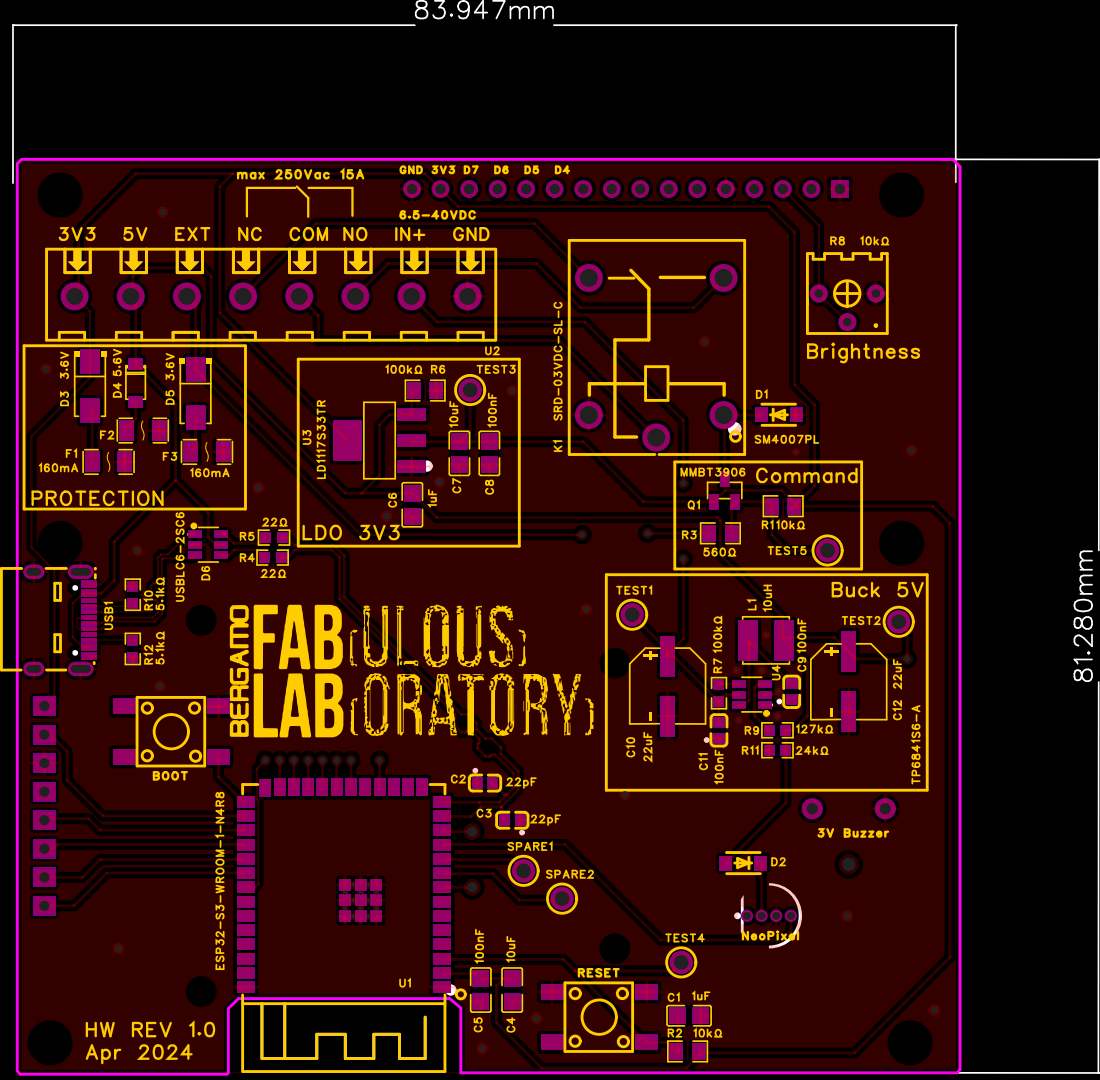
[picture p28: page 1]

R3560
TEST1

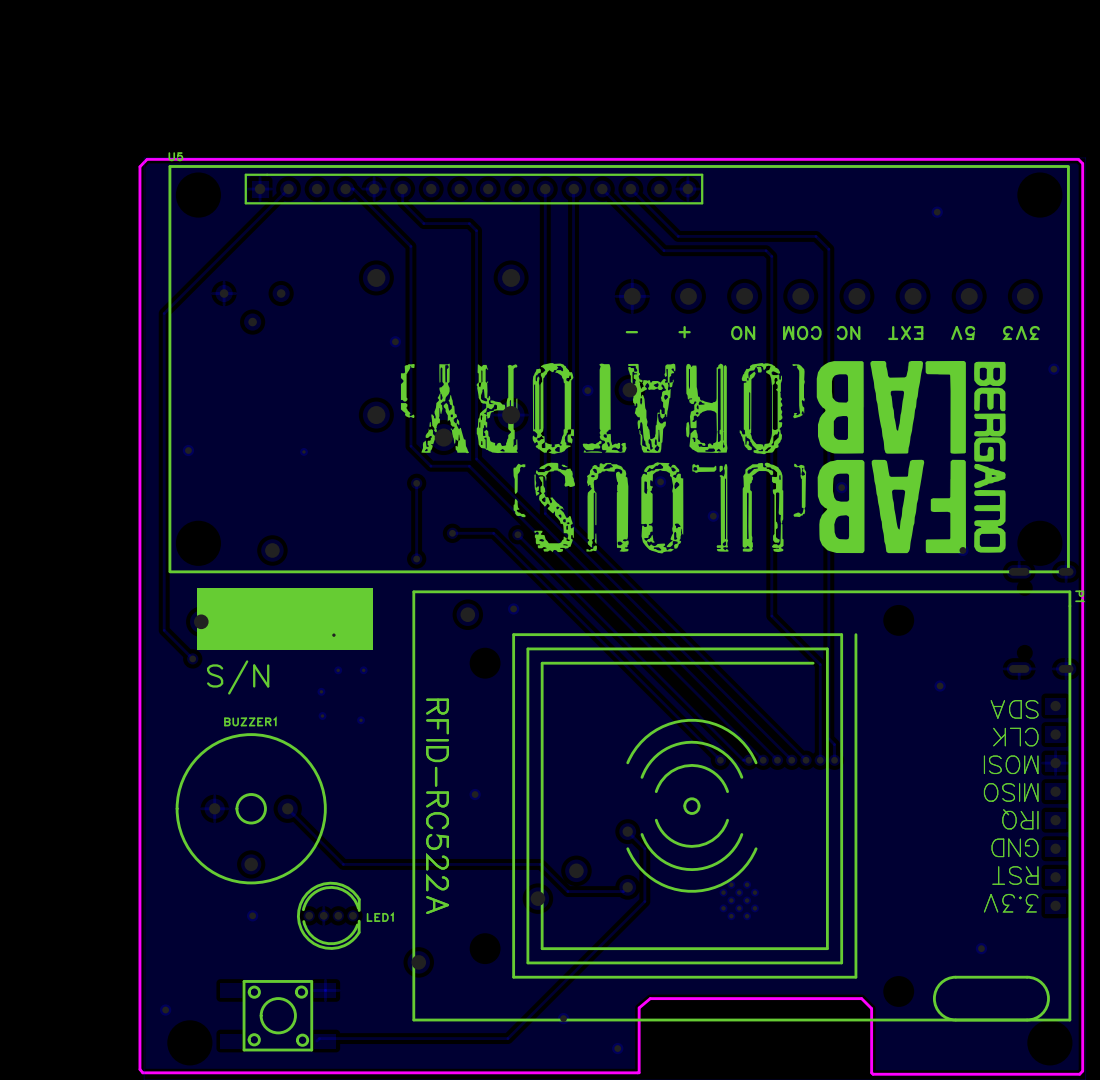
[picture p29: page 2]

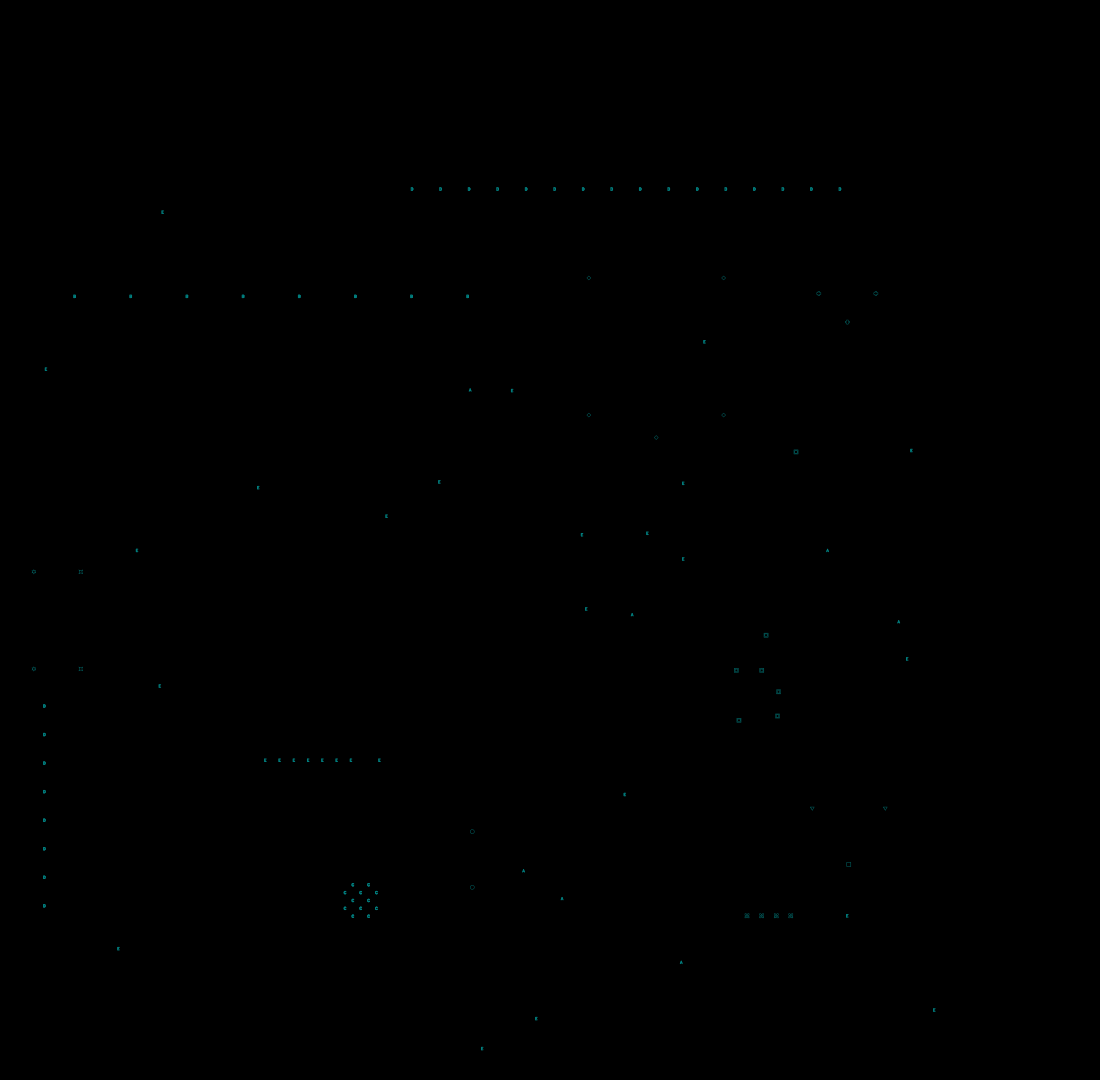
[picture p30: page 3]
