fablab-bergamo/Fab-O-matic/hardware/rev 1.0/schematics rev1.0.pdf

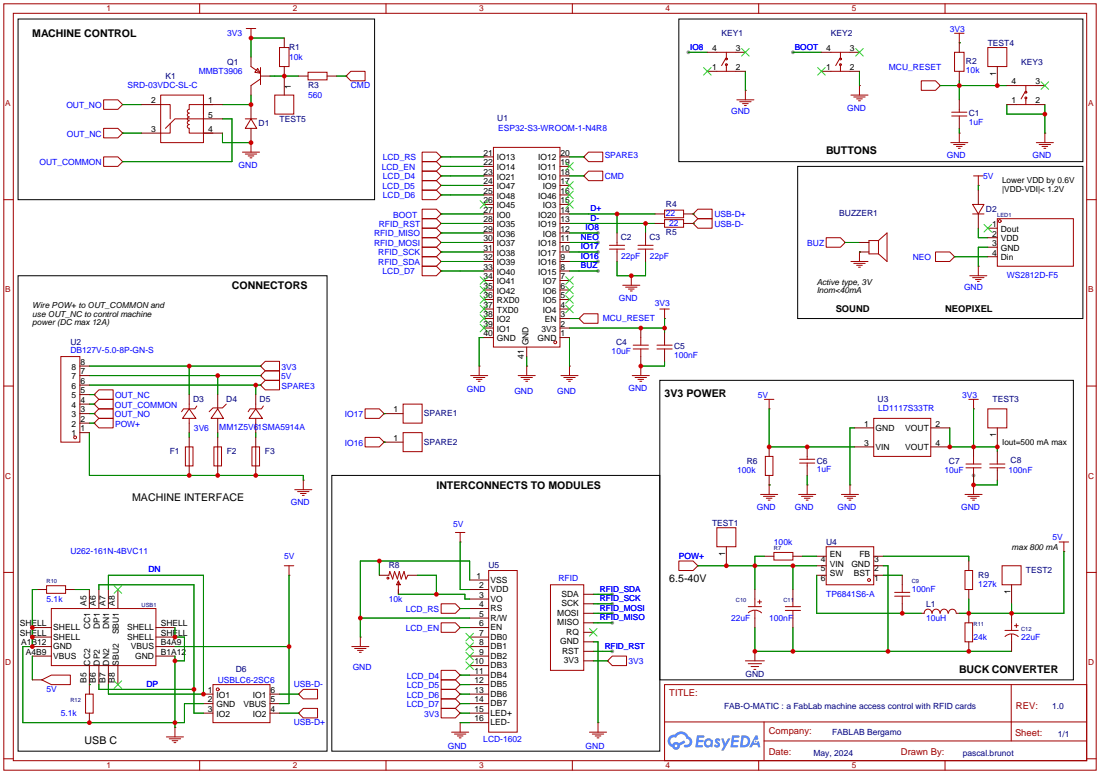
[picture p31: page 1]

Wire POW+ to OUT_COMMON and
use OUT_NC to control machine
power (DC max 12A)
