fablab-bergamo/Fab-O-matic/hardware/rev 0.4/PCB.pdf

# D4 D5 D6 D7 3V GND E B C

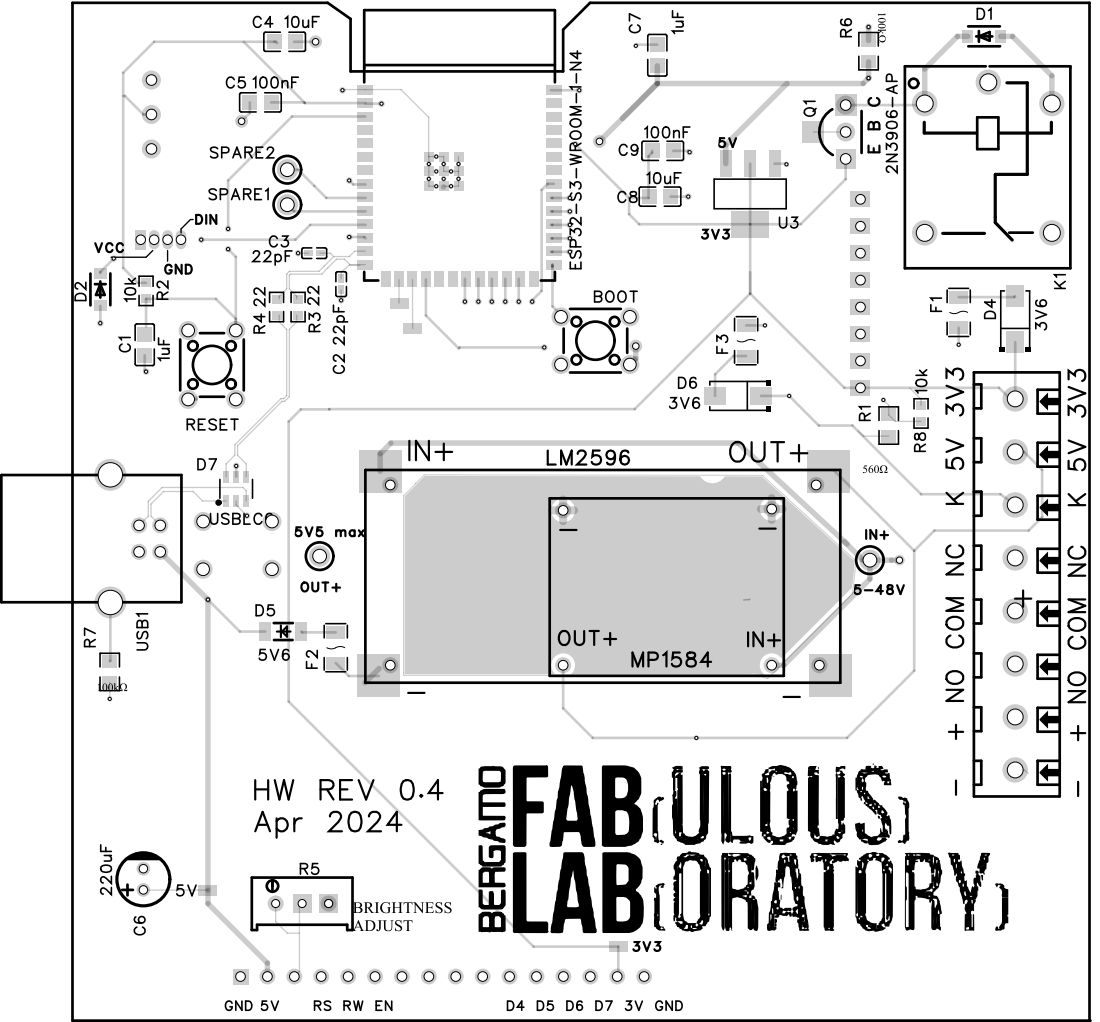
[picture p32: page 1]

# S/N5-46V in LCD 1802 module

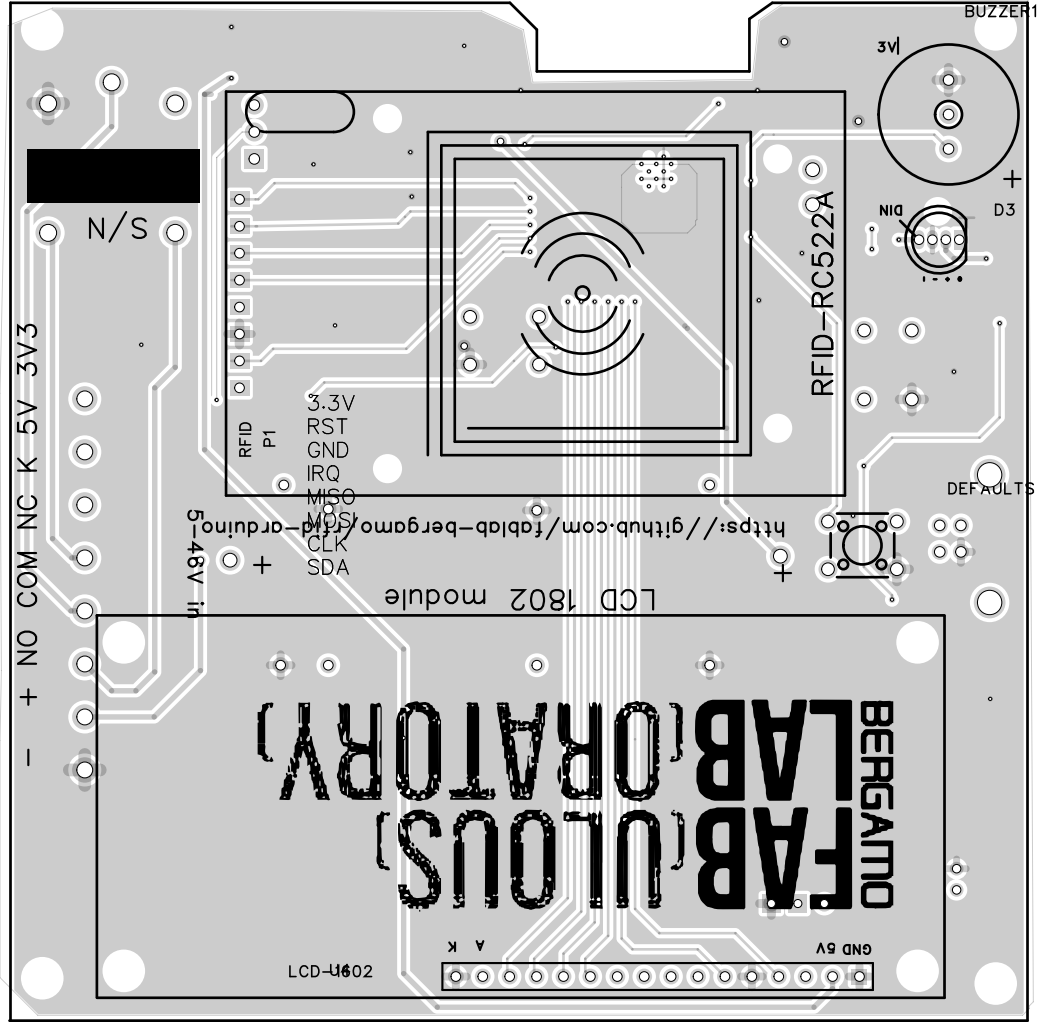
[picture p33: page 2]

https://github.com/fablab-bergamo/rfid-arduino

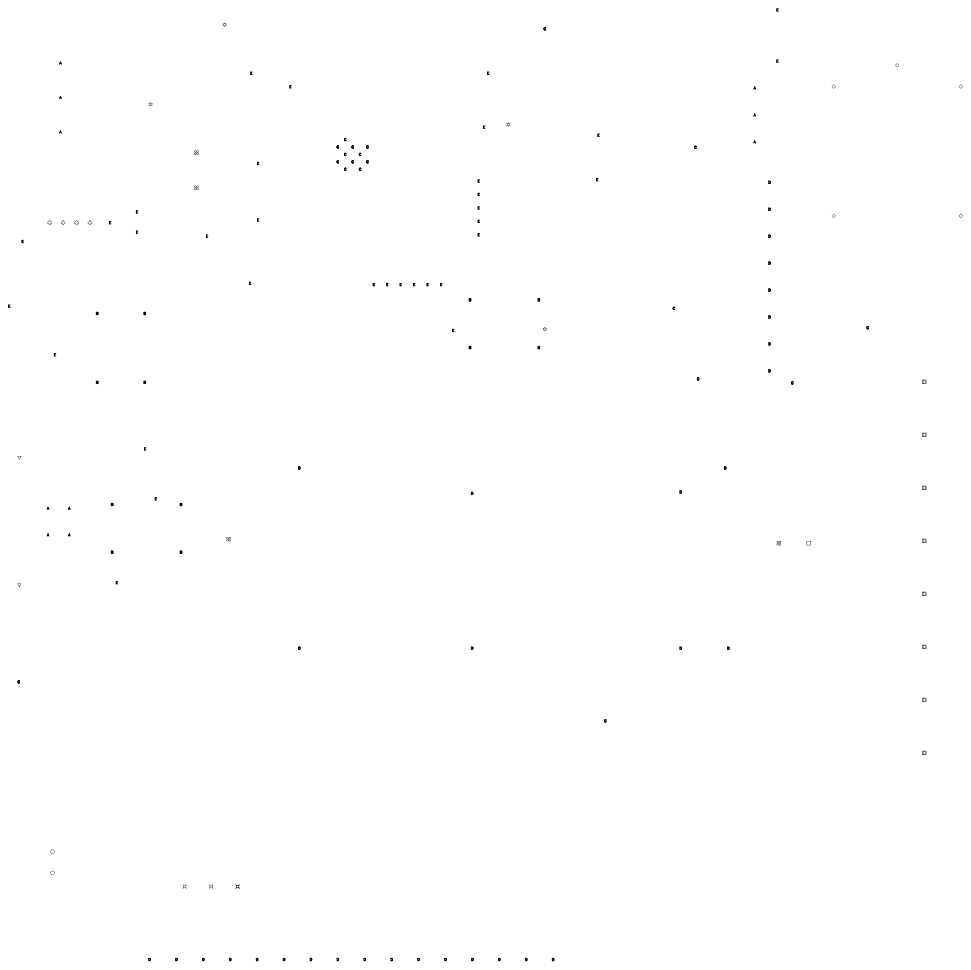
[picture p34: page 3]
