fablab-bergamo/Fab-O-matic/hardware/rev 0.3/Schematic_RFID-ARDUINO-FABLAB-BG-v2_2024-03-31.pdf

## BUTTONS MACHINE CONTROL

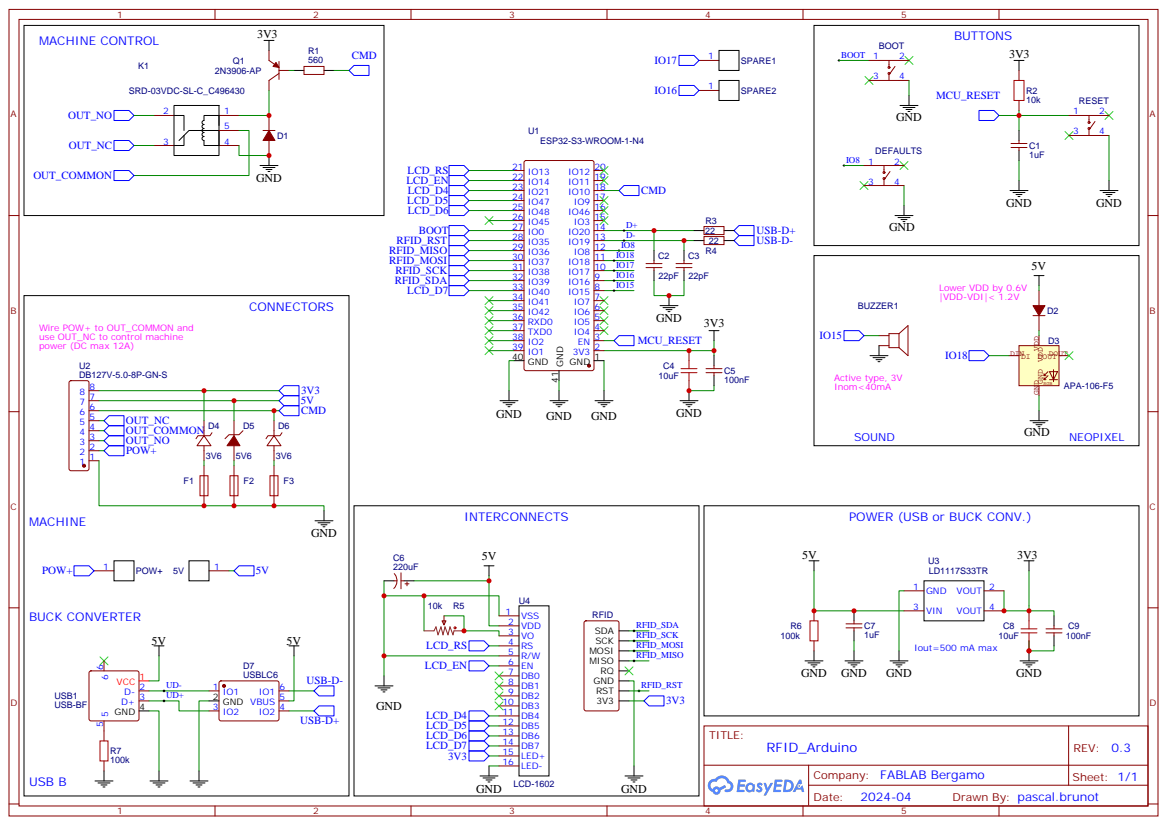
[picture p35: page 1]

Wire POW+ to OUT_COMMON and
use OUT_NC to control machine
power (DC max 12A)

POWER (USB or BUCK CONV.)

Drawn By: pascal.brunot
