fablab-bergamo/Fab-O-matic/hardware/rev 0.3/PCB_PCB-REV03_2024-03-31 top.pdf

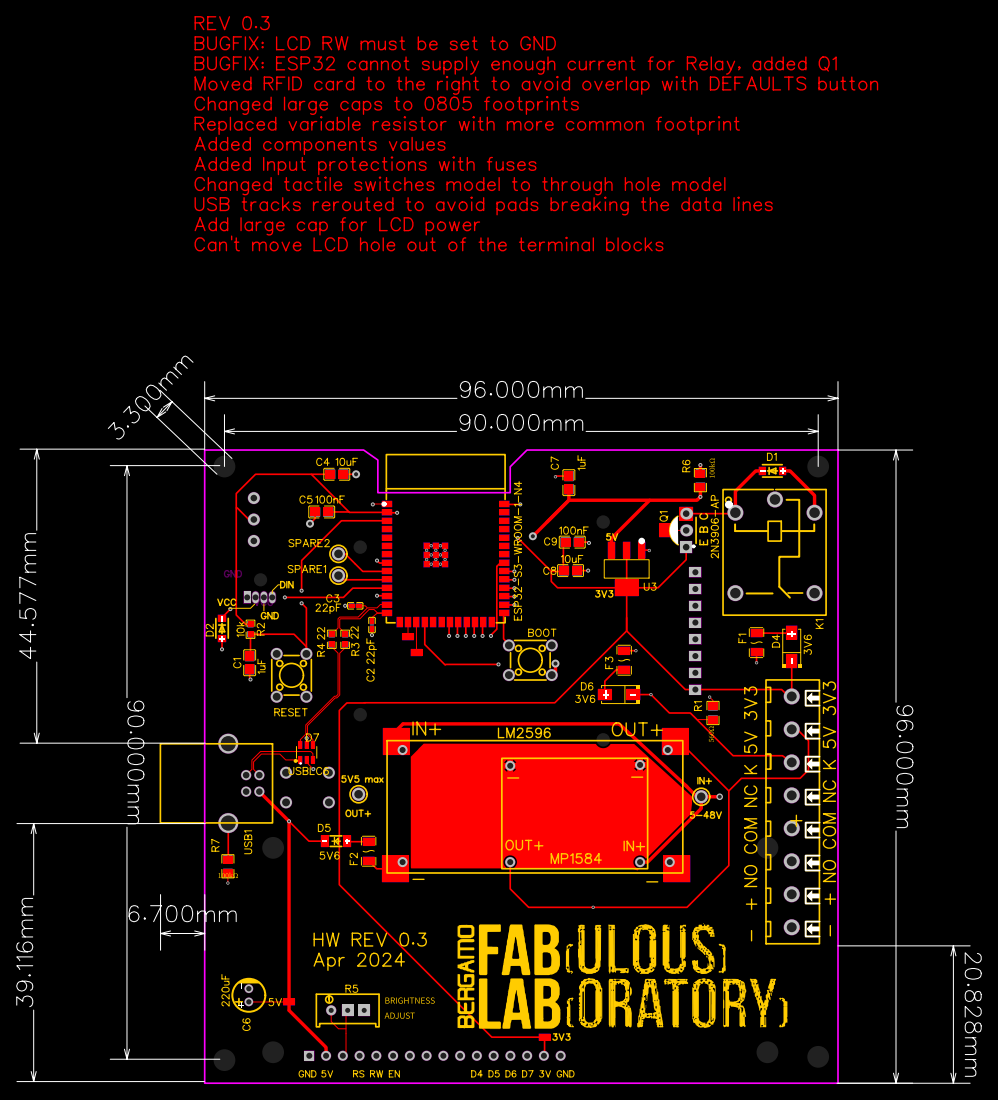
[picture p37: page 1]
