fablab-bergamo/Fab-O-matic/hardware/rev 0.2/PCB_PCB_RFID-ARDUINO-FABLAB-BG-copy_2024-03-10.pdf

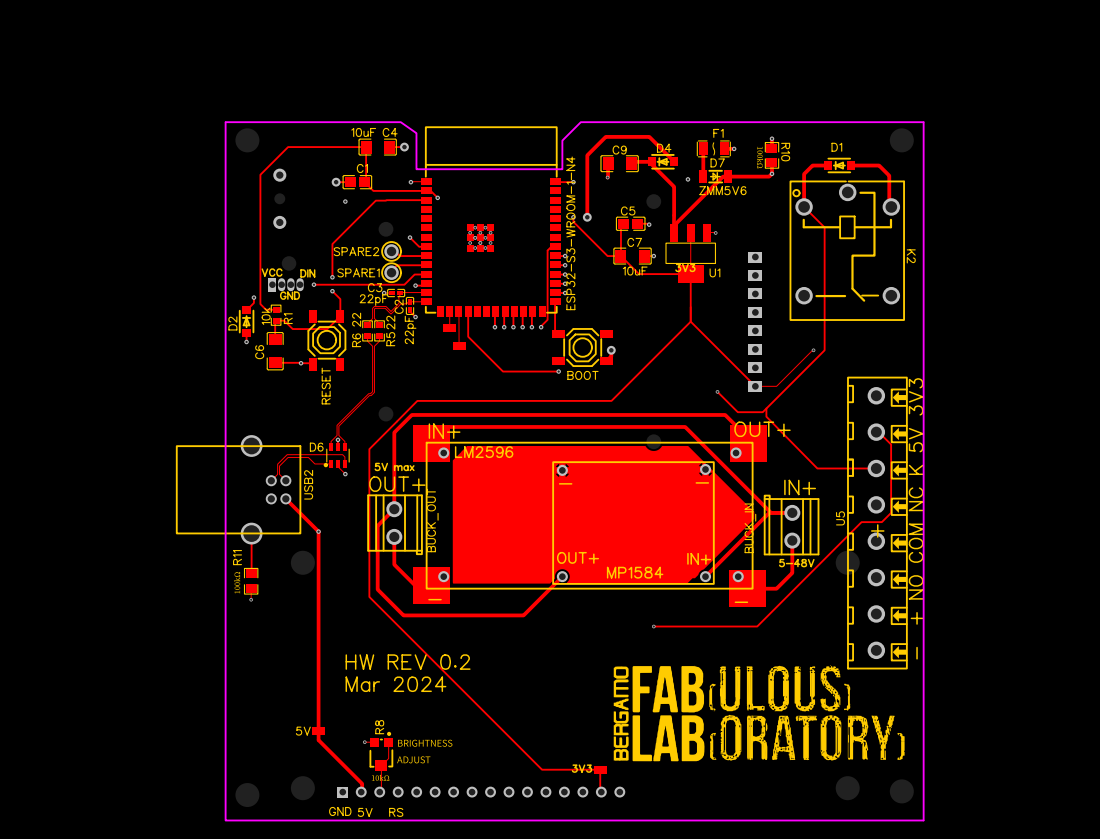
[picture p40: page 1]
