fablab-bergamo/Fab-O-matic/(list of files, drawings)

Other design files:
hardware/rev 0.2/SCH_RFID-ARDUINO-FABLAB-BG-v2_2024-03-10.json
hardware/rev 0.4/RFID Arduino REV04.eprj
hardware/rev 1.0/ProDocument_RFID-ARDUINO-FABLAB-BG_2024-05-04.epro
hardware/rev 1.1/ProDocument_FAB-O-MATIC_2024-05-19.epro
hardware/rev 1.2/ProProject_FAB-O-MATIC _ a FabLab machine access control with RFID cards_2024-06-24.epro
hardware/rev 1.3/ProPrj_FAB-O-MATIC-rev1.3_2024-08-18.epro
