fablab-bergamo/Fab-O-matic/include/card.hpp

#ifndef CARD_HPP_
#define CARD_HPP_

#include <sstream>
#include <iomanip>

#include "Arduino.h"
#include "conf.hpp"

#include "Logging.hpp"

namespace fabomatic::card
{
  using uid_t = u_int64_t;
  inline constexpr uid_t INVALID = 0ULL;

  /**
   * @brief Returns a string representation of the UID
   * @param uid number to convert
   * @return an hex string representation of the UID (e.g. "123456ADCD")
   */
  [[nodiscard]] inline auto uid_str(const card::uid_t uid) -> std::string
  {
    uint64_t number = static_cast<uint64_t>(uid);
    uint32_t long1 = static_cast<uint32_t>(number & 0xFFFF0000) >> 16;
    uint32_t long2 = static_cast<uint32_t>(number & 0x0000FFFF);

    std::stringstream ss{};
    ss << std::setfill('0') << std::setw(4) << std::hex << long1;
    ss << std::setfill('0') << std::setw(4) << std::hex << long2;
    return ss.str();
  }

  /**
   * @brief Returns an UID from its string representation
   * @param str hex string to convert
   * @return uid value
   */
  [[nodiscard]] inline auto str_uid(const std::string &str) -> card::uid_t
  {
    uint64_t ll_value;

    std::stringstream ss{};
    ss << std::hex << str;
    ss >> ll_value;

    return ll_value;
  }

  /**
   * @brief Converts a UID from an array of bytes to a number
   * @param uid array of bytes
   * @return the UID as a number
   */
  [[nodiscard]] constexpr inline auto from_array(const std::array<uint8_t, conf::rfid_tags::UID_BYTE_LEN> &uid) -> uid_t
  {
    card::uid_t result = 0;
    for (auto i = (conf::rfid_tags::UID_BYTE_LEN - 1); i >= 0; i--)
    {
      result <<= 8;
      result |= uid[i];
    }
    return result;
  }

  /// @brief Converts a UID from an array of bytes to a number
  /// @param uid array of bytes
  /// @return the UID as a number
  [[nodiscard]] constexpr inline auto to_array(const uid_t uid) -> const std::array<uint8_t, conf::rfid_tags::UID_BYTE_LEN>
  {
    std::array<uint8_t, conf::rfid_tags::UID_BYTE_LEN> retVal{0};
    for (auto i = (conf::rfid_tags::UID_BYTE_LEN - 1); i >= 0; i--)
    {
      retVal[i] = (uid >> (i * 8)) & 0xFF;
    }
    return retVal;
  }

  inline auto print(uint64_t uid) -> void
  {
    ESP_LOGI(TAG, "Card UID = %s", card::uid_str(uid).c_str());
  }
} // namespace fabomatic::card
#endif // CARD_HPP_
