fablab-bergamo/Fab-O-matic/include/AuthProvider.hpp

#ifndef AUTHPROVIDER_HPP_
#define AUTHPROVIDER_HPP_

#include <list>
#include <string>
#include <string_view>
#include <tuple>
#include <optional>

#include "FabUser.hpp"
#include "secrets.hpp"
#include "WhiteList.hpp"
#include "CachedCards.hpp"

namespace fabomatic
{
  /// @brief This class manages authentication of a RFID tag through cache, whitelist or network request.
  class AuthProvider
  {
  private:
    WhiteList whitelist;
    mutable CachedCards cache;
    mutable size_t cache_idx{0};
    [[nodiscard]] constexpr auto uidInWhitelist(card::uid_t uid) const -> std::optional<WhiteListEntry>;
    [[nodiscard]] constexpr auto uidInCache(card::uid_t uid) const -> std::optional<CachedCard>;
    [[nodiscard]] constexpr auto searchCache(card::uid_t candidate_uid) const -> std::optional<CachedCard>;
    constexpr auto updateCache(card::uid_t candidate_uid, FabUser::UserLevel level) const -> void;

  public:
    AuthProvider() = delete;
    AuthProvider(WhiteList whitelist);
    [[nodiscard]] auto tryLogin(card::uid_t uid, FabBackend &server) const -> std::optional<FabUser>;
    auto setWhitelist(WhiteList list) -> void;
    auto saveCache() const -> bool;
    auto loadCache() -> void;
  };
} // namespace fabomatic
#endif // AUTHPROVIDER_HPP_
