fablab-bergamo/Fab-O-matic/(commit log)

2023-04-10 implementing comments from #1
    see https://github.com/fablab-bergamo/rfid-arduino/pull/1
    except const expr for compatibility reasons with base library LCD
    applied code formatting + esp32s3 testing
2023-04-10 refactoring LCDWrapper
    the LCDWrapper will decide what to write in each row based on current state, and update function arguments.
    main function has only to update the state
2023-04-10 platformio config for both ESP32 + ESP32S3
    pins.h config via #define
    comments improvement
    Update README.md
2023-04-10 refactoring and PR #2 comments implementation
    replaced enum with enum class
    added BoardState class which wraps lcd, rfid, current user, server, machine and provides higher level function to the main.cpp
    comments implementation of PR #2
    memcpy instead of for loop
    removed underscores for private members
    init inline in the header
    consistent usage of this->
    [FabServer.cpp, FabServer.h, Machine.cpp, Machine.h, main.cpp]
2023-04-10 testing on esp32s3
2023-04-10 removed pointers
    LCD setRow is now public
    LCD text logic moved from LCD to BoardState
2023-04-10 struct and constexpr for pins definition
    https://github.com/fablab-bergamo/rfid-arduino/pull/2#discussion_r1161162071
2023-04-10 created struct for MachineId instead of uint16_t
    https://github.com/fablab-bergamo/rfid-arduino/pull/2#discussion_r1161157999
2023-04-10 first working version on ESP32s3
    bugfix user_name display
    tested with ESP32S3
    it reads RFID tag, matches against whitelist, updates the LCD as expected
    debugging
    LCDWrapper : eliminated casts and connection status member, added pretty print for debugging
    [Machine.cpp, Machine.h, RFIDWrapper.cpp, RFIDWrapper.h, main.cpp, pins.h]
2023-04-10 AuthProvider class + testing
    removed RFIDWrapper::SetUid
    it works fine so far with LCD+RFID reader.
    testing required for machine output enable, wrong rfid tags
    still missing server interactions
    [AuthProvider.cpp, AuthProvider.h, FabServer.cpp, FabServer.h, FabUser.h, Machine.cpp, Machine.h, RFIDWrapper.cpp]
2023-04-10 added maintenance and allowed flags for Machine
    allows the server to return to the arduino client the status of the machine: if maintenance is needed, and if usage of the machine is allowed.
    board now checks server at startup and tries to get up-to-date machine information.
    server returns name of holder if uid is valid.
    not sure if the actual usage time of the machine shall be monitored by arduino (maybe based on one RUNNING signal from the machine) or done purely server-side, based on login/logout times.
2023-04-10 added delay for powering off and icon
    added new icons to show the power status to the machine (on, off, powering off delay).
    added new constants to configure the delays in conf::machine
    added provision for audible warning before power-off in main
2023-04-29 Added MQTT client, Maintenance tap feature, C++ style rework, Tasks (#3)
    * implementing comments from #1
    * refactoring LCDWrapper
    * platformio config for both ESP32 + ESP32S3
    * refactoring and PR #2 comments implementation
    added BoardState class which wraps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
    [AuthProvider.cpp, AuthProvider.h, BoardLogic.cpp, BoardLogic.h, FabServer.cpp, FabServer.h, FabUser.h, MQTTtypes.cpp]
2023-04-30 Squashed commit of the following:
    commit cf724f6be58a4f8415993312ad86a94df52ccbef
    Author: Pascal Brunot <pascal.brunot@gmail.com>
    Date: Sun Apr 30 11:44:11 2023 +0200
    added wokwi project
    added wokwi build & URL
    pinning platformio to espressif32 6.1.0
    6.2.0 fails to build
    commit 10273d7d818fca29bae10a0807283af2843b0e39
    Merge: 6b0e9fd 5c787bf
    Author: Pascal Brunot <pascal.brunot@gmail.com>
    Date: Sun Apr 30 11:43:43 2023 +0200
    Merge branch 'main' of https://github.com/PBrunot/rfid-arduino
    commit 5c787bf201ea7076bf0347a168ba50b1119bf8b2
    Author: Pascal Brunot <pascal.brunot@gmail.com>
    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
    [AuthProvider.cpp, BoardLogic.cpp, FabServer.cpp, FabServer.h, MQTTtypes.cpp, Machine.cpp, MockRFIDWrapper.h, RFIDWrapper.cpp]
2023-04-30 WOKWI + bugfix autologout
    WOKWI: added MQTT broker in a separate pthread
    [BoardLogic.cpp, BoardLogic.h, FabServer.cpp, FabServer.h, Machine.cpp, MockMQTTBroker.cpp, MockMQTTBroker.h, globals.h]
2023-04-30 ESP32S3 testing
2023-04-30 rewritten time logic with chrono
    bugfix whitelist not checked if MQTT offline
    [AuthProvider.cpp, BoardLogic.cpp, FabServer.cpp, FabServer.h, MQTTtypes.cpp, MQTTtypes.h, Machine.cpp, Machine.h]
2023-12-25 Configuration of MQTT (Shelly) / std relay in conf.hpp
2023-12-27 BoardLogic: added codes for web portal on LCD
2023-12-28 Unity tests implementation
    Refactoring BoardLogic to allow unity testing with mockups
    Unity tests on BoardLogic (WIP)
2023-12-29 more Unity tests, 1 still failing (longtap)
    +fix filename casing
    [AuthProvider.cpp, AuthProvider.hpp, BoardLogic.cpp, BoardLogic.hpp, FabUser.hpp, MockMQTTBroker.cpp, MockMQTTBroker.hpp, RFIDWrapper.cpp]
2023-12-29 Trying to fix longTap(), unsuccessfully
    I need to test with real RFID hardware as it may be a simulation bug rather than a real bug.
    [BaseRfidWrapper.hpp, BoardLogic.cpp, MockMQTTBroker.cpp, MockRFIDWrapper.hpp, RFIDWrapper.cpp, RFIDWrapper.hpp]
2023-12-31 AuthProvider: added param FabServer& to avoid globals
    [AuthProvider.cpp, AuthProvider.hpp]
2023-12-31 Removed global variable FabServer, now inside BoardLogic
2024-01-04 Logging, bugfixes, improved tests.
    Replaced all Serial.print with ESP_LOG functions, which are compatible with Unity testing.
    Added various tests with simulated MQTT brokers.
    Various bugfixes.
    commit 8aaae0dca0619b5f03b9d23c9a2e0d17251b2606
    Date: Thu Jan 4 11:45:09 2024 +0100
    logging: removed Serial.print for ESP_LOG* functions
    commit e1a43a49e0e4fbe9930012e206f4a702f12b5dad
    Date: Thu Jan 4 11:27:35 2024 +0100
    Added comments
    commit bb22bd7d2d82b281db57fe9a23e7c93cfa9cf04e
    Date: Thu Jan 4 11:02:28 2024 +0100
    Tasks: run the most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
    [AuthProvider.cpp, BoardLogic.cpp, BoardLogic.hpp, FabServer.cpp, FabServer.hpp, Logging.hpp, MQTTtypes.cpp, Machine.cpp]
2024-01-12 Removed c++ exceptions, added support for Github tests with wokwi (#11)
    * filenames for linux compilation
    * removed exceptions, fixed format strings warnings
    * Update platformio.ini
    * moved config files to dedicated folder
    [BoardLogic.cpp, BoardLogic.hpp, FabServer.cpp, Tasks.cpp, main.cpp]
2024-01-14 FabServer: bugfix double publish if answer is not fast enough
    [FabServer.cpp]
2024-01-18 Relay active_low configuration
2024-01-19 Relay: bumpless reset in OFF state. NeoPixel: Fixed RGB colors.
    [BoardLogic.cpp, BoardLogic.hpp, Machine.cpp, main.cpp]
2024-01-20 Led/NeoPixel: separated into distinct class
2024-01-20 Machine: bugfix mqtt attempt on start before network starts
    [Machine.cpp, Machine.hpp]
2024-01-20 adding ESP32 WROVER board
    https://docs.espressif.com/projects/esp-idf/en/latest/esp32/hw-reference/esp32/get-started-wrover-kit.html
2024-01-20 added wrover kit board for debugging
2024-01-21 Wokwi: added NeoPixel. Fixed LCD refresh issue with pin init.
    Fixed inverted relay in simulation
    Fixed duplicated pins in configuration of Wokwi
    Removed now useless refreshLCD method.
    [BoardLogic.cpp, BoardLogic.hpp, main.cpp]
2024-01-21 esp32: fixed duplicate RFID Reset pin
2024-01-21 added EEPROM default reset flag
    [SavedConfig.cpp, main.cpp]
2024-01-22 MQTT: added regular "inUse" message
    Goal is to limit information loss if the machine and the board are powered off during use. With this information the backend can save the last time the machine was used and eventually close the record at next start or after delay,
    Renamed FabServer to FabBackend for consistency with Python project.
2024-01-25 making MQTT / HW classes final. BoardLogic: removed mutable
2024-01-27 OTA implementation
    commit 4ac46615a92445c92750ba1bf8026f23d3e88786
    Date: Sat Jan 27 11:11:56 2024 +0100
    tested OTA
    board will not reboot if the machine is powered on to avoid disrupting the user
    commit dbcb6f7c9ce5d9f610b6dd555439f1e67cec7d7f
    Date: Fri Jan 26 23:09:17 2024 +0100
    Update pins.hpp
    commit dbd762464a0cc81b88fc9513710721b883b90cf5
    Date: Fri Jan 26 21:58:55 2024 +0100
    ArduinoOTA integration
    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
    [BoardLogic.cpp, BoardLogic.hpp, FabBackend.cpp, Machine.cpp, Mrfc522Driver.cpp, Tasks.cpp, Tasks.hpp]
2024-01-27 bugfix: Allow OTA in case of RFID HW failure
    [BoardLogic.cpp, main.cpp]
2024-02-03 added factory defaults reset button
2024-02-04 Add draft PCB 3D model
2024-02-11 fixed all clang-tidy warnings
    [AuthProvider.cpp, AuthProvider.hpp, BaseRfidWrapper.hpp, BoardLogic.cpp, BoardLogic.hpp, FabBackend.cpp, FabBackend.hpp, FabUser.hpp]
2024-02-11 fix clang warning on exceptions for static broker object
    [MockMQTTBroker.cpp, MockMQTTBroker.hpp]
2024-02-14 Factory defaults button now pull_up (saving 1 R)
2024-02-17 OTA: added failed OTA message on LCD
    [BoardLogic.cpp, BoardLogic.hpp, main.cpp]
2024-02-17 compilation flags reworked (MQTT/RFID_SIMULATION)
    [FabBackend.cpp, Tasks.cpp, globals.hpp, main.cpp]
2024-02-17 Led: added RGB support for esp32 wroverkit
2024-02-22 fixed logging preprocessor configuration
    [BoardLogic.cpp]
2024-03-10 first version ordered on JLCPCB
    [BOM_RFID-ARDUINO-FABLAB-BG-v2_2024-03-10.csv, SCH_RFID-ARDUINO-FABLAB-BG-v2_2024-03-10.json]
2024-03-26 Configured high current mode for relay and buzzer pins
    [BoardLogic.cpp, Machine.cpp]
2024-03-29 Trying to find the right board for esp32s3-wroom-1-n4
2024-03-30 esp32s3: PWM channel set to 2 to avoid crashes with beep function
    [BoardLogic.cpp]
2024-03-30 bugfix mfc522 reset initialization
    [BoardLogic.cpp, Mrfc522Driver.cpp, Mrfc522Driver.hpp]
2024-03-30 Improvement to HW errors handling
    Update main.cpp
    [main.cpp]
2024-03-31 HW REV 0.3
    [BOM_RFID-ARDUINO-FABLAB-BG-v2_2024-03-31.csv]
2024-03-31 as built JLCPCB
    [BOM_RFID-ARDUINO-FABLAB-BG-v2_2024-03-31.csv]
2024-04-01 added interactive soldering map
    from EasyEDA Pro (free)
2024-04-01 PCB instructions
2024-04-02 Tasks members renaming; failed HW init allows for OTA
    [Tasks.cpp, Tasks.hpp, main.cpp]
2024-04-02 renaming methods for case consistency
2024-04-03 Relay command is now active_low
    ESP32 is driving low the base of a PNP transistor with a weak pull-up.
2024-04-03 fixing the tests + slowness while factory_button is pressed
    [MockMQTTBroker.cpp, main.cpp]
2024-04-07 rev 0.4 hardware
    [BOM_RFID Arduino REV04_1-PCB_PCB REV04_2024-04-07.xlsx, PickAndPlace_1-PCB_PCB REV04_2024-04-07.xlsx, RFID Arduino REV04.eprj]
2024-04-13 Factory reset now opens config portal
    [main.cpp]
2024-04-13 moved cache load to board config
    if done too early in the boot process, EEPROM library does not work.
    [AuthProvider.cpp, BoardLogic.cpp]
2024-04-15 rev 1.0 for JLCPCB sponsorship
    [BOM_RFID-ARDUINO-FABLAB-BG_PCB REV1.0_2024-04-15 (1).xlsx, PickAndPlace_PCB REV1.0_2024-04-15.xlsx, ProDocument_RFID-ARDUINO-FABLAB-BG_2024-04-15.epro]
2024-04-16 bugfixes
    cache rfid and text on LCD when machine is blocked
    [AuthProvider.cpp, BoardLogic.cpp]
2024-04-21 FORCE_OPEN_PORTAL now works once
    If the firmware is compiled with FORCE_OPEN_PORTAL, it will always reopen the config portal at boot, then wait for timeout. This change opens the portal at boot only once (more exactly, only once after successfull configuration, in case of failure it will reopen). Also, device is rebooted after portal config, rather than applying changes on the fly (I observed it does not work for WiFi network).
    [SavedConfig.cpp, SavedConfig.hpp, main.cpp]
2024-04-22 RFID Cache - bugfixes
    [AuthProvider.cpp, BoardLogic.hpp, FabBackend.cpp, Tasks.hpp, WhiteList.hpp]
2024-04-22 Bugfix: cache invalidation for disabled users on backend
    Update conf.hpp
    [AuthProvider.cpp, BoardLogic.cpp, FabUser.hpp]
2024-04-25 RFID Cache: skip cache for null cards
    [AuthProvider.cpp]
2024-04-27 Github actions and C++ style improvements (#15)
    * C++ style improvements+ tests rework
    * Make buzzer less noisy by limiting current
    * Adding firmware size statistics
    * Different caches
    * Size reports
    * Github actions improvements with matrixes
    [AuthProvider.cpp, BoardLogic.cpp, Led.cpp, main.cpp]
2024-04-27 Added card::esp_serial() method to get ESP unique ID (#17)
    fixed loop of portal reset for board rev 0.2
    fixed misunderstood method wifiManager.setDisableConfigPortal(true);
    [FabBackend.cpp, MQTTtypes.cpp, card.hpp, main.cpp]
2024-04-28 added const to auto variable declarations, SavedConfig use JSON (#18)
    * added const to auto variable declarations
    added const to auto variable declarations
    Update card.hpp
    * SavedConfig: use JSON format for persistance
    This will allow to implement graceful firmware "upgrades" without worrying about internal structure. Right now the configuration is reset if the magic number changes.
    * fixing tests after SavedConfig interface changes
    * SavedConfig as JSON document bugfixes
    * Update sizes.yml
    * upgrade to github script v7
    * Leave size comments only for latest commit to the PR
    * Leave size comments only for latest commit to the PR
    * SavedConfig: skip empty entri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
    [AuthProvider.cpp, BoardLogic.cpp, FabBackend.cpp, FabUser.hpp, Led.cpp, MQTTtypes.cpp, Machine.cpp, MachineConfig.hpp]
2024-04-28 Tests case rework (#19)
    * SavedConfig : JSON processing debugging
    * tests: added coverage for RFID cache, invalid users
    * MockMQTT: added simulation by whitelist data
    * missing include
    * tryLogin returns a FabUser if the server returned an answer, even if not valid
    * protect concurrent access with mutex/lock_guard pattern
    * Update README.md
    [AuthProvider.cpp, MockMQTTBroker.cpp, MockMQTTBroker.hpp, SavedConfig.cpp, SavedConfig.hpp, main.cpp]
2024-05-01 renaming Rfid-Arduino to FAB-O-MATIC
2024-05-04 finalizing HW rev1.0 for manufacturing
    [BOM_RFID-ARDUINO-FABLAB-BG_PCB REV1.0_2024-04-15 (1).xlsx, BOM_RFID-ARDUINO-FABLAB-BG_PCB REV1.0_2024-05-04.xlsx, PickAndPlace_PCB REV1.0_2024-04-15.xlsx, PickAndPlace_PCB REV1.0_2024-05-04.xlsx, ProDocument_RFID-ARDUINO-FABLAB-BG_2024-04-15.epro, ProDocument_RFID-ARDUINO-FABLAB-BG_2024-05-04.epro]
2024-05-04 Added translations for portal text
    And removed FABLAB_* for FABOMATIC_*
    CppLinter fixes
    [MockMQTTBroker.cpp, main.cpp]
2024-05-17 HW rev 1.1 (#24)
    bugfix R9 between 5V and GND instead of FB pin and GND
    published hw rev 1.1 manufacturing data
    [BOM_FAB-O-MATIC_PCB REV1.1_2024-05-17.xlsx, PickAndPlace_PCB REV1.1_2024-05-17.xlsx, ProDocument_FAB-O-MATIC_2024-05-17.epro]
2024-05-18 Faster boot, red LED on HW (#25)
    * Make boot faster by skipping portal timeout error
    * Flash red in case of HW failure
    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
    [SavedConfig.cpp, main.cpp]
2024-05-18 HW revision 1.1
    Errata of HW REV 1.0 updated and fixed
    [BOM_FAB-O-MATIC_PCB REV1.1_2024-05-17.xlsx, BOM_FAB-O-MATIC_PCB REV1.1_2024-05-18.xlsx, PickAndPlace_PCB REV1.1_2024-05-17.xlsx, PickAndPlace_PCB REV1.1_2024-05-18.xlsx, ProDocument_FAB-O-MATIC_2024-05-17.epro, ProDocument_Schematics_2024-05-18.epro]
2024-05-19 Create Wrong footprint - C7420354 component.pdf
2024-05-19 Schematics tidy up
    [ProDocument_FAB-O-MATIC_2024-05-19.epro, ProDocument_Schematics_2024-05-18.epro]
2024-05-20 Buzzer: removed frequency generation as buzzer is active type 3V
    [BoardLogic.cpp]
2024-05-25 Increase WiFi tx power
2024-05-25 Removed useless WiFi power settings as ESP32 boots with max power
2024-05-26 Buffering MQTT messages, issue #14 (#30)
    * Removed useless WiFi power settings as ESP32 boots with max power
    * WIP implementation buffer for MQTT messages
    * BufferedMsg: added tests and debugging
    * BufferedMsg: added configuration flag
    * BufferedMsg: added persistence in JSON format
    * BoardLogic: bugfix strings for maintenance prompt
    * FabBackend: added retransmission before sending new messages
    * BufferedMsg: tests rework
    * FabBackend: do not transmit messages twice
    * FabBackend: added tests for message retransmission
    * FabBackend: added tests for message retransmission
    * BufferedMsg: added periodical save to flash memory
    * Card: compute esp_serial only o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
    [BoardLogic.cpp, BufferedMsg.cpp, BufferedMsg.hpp, FabBackend.cpp, FabBackend.hpp, LCDWrapper.hpp, MQTTtypes.hpp, SavedConfig.cpp]
2024-05-27 Esp32: moved all espressif API into a dedicated namespace
    to facilitate porting to other IDF/MCU in the future
2024-05-27 Esp32: compatibility with IDF 5.1
2024-05-27 Esp32: tests
2024-06-01 Espressif: bugfix MAC address
    [Espressif.cpp]
2024-06-02 Bugfix #32 + Buzzer class and tests
    [BoardLogic.cpp, BoardLogic.hpp, Buzzer.cpp, Buzzer.hpp, Machine.cpp, PinsConfig.hpp]
2024-06-16 Wrapped ESP.reset() inside esp32 namespace
    [Espressif.cpp, Espressif.hpp]
2024-06-24 HW REV 1.2
    Changes from rev 1.1:
    * Added D7 and D8 for reverse voltage protection on 5V and POW+ external pins.
    * Removed non-working over-voltage protection zener diodes.
    * Unconnected terminal block pin 8 (previously, it was an output 3V3).
    * Added R13/R14/R15 to tolerate 5V input if R16 is removed.
    * (Color PCB) Added small vias on color PCB to allow NeoPixel light to filter through.
    ⚠ Errata in this revision ⚠
    * None known
    [BOM_FAB-O-MATIC_FAB-O-MATIC_2024-06-24.xlsx, PickAndPlace_PCB REV1.2_2024-06-24.xlsx, ProProject_FAB-O-MATIC _ a FabLab machine access control with RFID cards_2024-06-24.epro]
2024-06-30 MQTT: streaming Arduino String can be done without cstr()
2024-07-09 MQTT: bugfix only first IP char is sent in aliveMessage
    [MQTTtypes.cpp]
2024-07-14 Upgrade to Arduino 3.0.2 + IDF v5.1.4 via Tasmota esp32 platform (#31)
    * Arduino 3.0, IDF 5.1 changes
    * Updated to Arduino-3.0.0-rc3
    * Removed constexpr due to linker warnings
    * Fixed compiler warning on format string
    * Updated watchdog to IDF v5.1 API
    * Logging : now working with Arduino 3.0
    * Tests: fixed logging
    * Watchdog: fixed failed initialization
    * Esp32: compatibility with IDF 5.1
    * Reduced warnings/errors
    * Added colored output
    * Update test_mqtt.cpp
    * Updated workflows to run if needed
    * Github actions: added sizes
    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
    [AuthProvider.cpp, AuthProvider.hpp, BoardLogic.cpp, BufferedMsg.cpp, CachedCards.hpp, FabBackend.cpp, Logging.hpp, Machine.cpp]
2024-07-20 Enclosure for 3D printing (FreeCAD+STL) for HW REV 1.x (#34)
    * Add files via upload
    file stl e freecad 0.21
    * Rename scatola_stampa3D_v6.FCStd to enclouser/scatola_stampa3D_v6.FCStd
    * Rename scatola_stampa3D_v6_CASE.stl to enclouser/scatola_stampa3D_v6_CASE.stl
    * Rename scatola_stampa3D_v6_TAPPO.stl to enclouser/scatola_stampa3D_v6_TAPPO.stl
    * Add files via upload
    * Rename enclouser/IMG_20240713_195248.jpg to enclouser/foto/IMG_20240713_195248.jpg
    * Add files via upload
    aggiunto foto
    * Add files via upload
    * Delete enclouser/foto/IMG_20240713_195248.jpg
    deleted invalid file
    * Delete enclouser/foto/IMG_20240713_194319.jpg
    delete for rotating
    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
    [scatola_stampa3D_v6.FCStd, scatola_stampa3D_v6_CASE.stl, scatola_stampa3D_v6_TAPPO.stl]
2024-07-20 Printable enclosure : renaming and moving files
    [scatola_stampa3D_v6.FCStd, scatola_stampa3D_v6_CASE.stl, scatola_stampa3D_v6_TAPPO.stl]
2024-07-20 Added enclosure info
2024-07-28 OTA: make sure WiFi is enabled in HW failure case
    [OTA.cpp, main.cpp]
2024-08-11 Trying to solve repeated start/stop use events in short periods
    Probably the user is keeping the card a little bit too long on the box, so I added a configuration settings with 2s default value to disable RFID readings.
    [BaseRfidWrapper.hpp, BoardLogic.cpp, BoardLogic.hpp, RFIDWrapper.hpp]
2024-08-12 esp32: Added reset code as string
    [Espressif.cpp, Espressif.hpp, main.cpp]
2024-08-12 Various CPPLinter warnings fixes
    [BaseRfidWrapper.hpp, BufferedMsg.hpp, FabBackend.cpp, FabBackend.hpp, LCDWrapper.cpp, MQTTtypes.cpp, MachineConfig.cpp, MockMQTTBroker.cpp]
2024-08-12 Added tests for esp32 functions
2024-08-16 FabBackend: handle failure mode (backend down, broker up)
    [BoardInfo.hpp, BoardLogic.cpp, FabBackend.cpp, FabBackend.hpp, LCDWrapper.cpp]
2024-08-16 Debug: replaced %lld with PRId64 format specifier
    [FabBackend.cpp, Machine.cpp]
2024-08-16 FabBackend: fail fast on unresponsive backend
    [AuthProvider.cpp, FabBackend.cpp, FabBackend.hpp]
2024-08-16 Task: connect() shall fail fast is backend is unresponsive
    [main.cpp]
2024-08-16 HW: laser-cut enclosure for HW REV 0.x boards
    Original design with FreeCAD + Interlock plugin. Modifications done with Fusion360 Personal Use. Software for laser : AutoLaser 2.6.9.
    [fabomatic hw rev0 taglio laser.dxf]
2024-08-16 Update fabomatic hw rev0 taglio laser0.wcvr
2024-08-16 HW: added notes regarding AC MAINS safety and reverse power flows.
2024-08-17 Bugfix: relay set on boot with HW REV 0.3
    Needs to be tested with HW REV 1.x too
    [BoardLogic.cpp, Machine.cpp, main.cpp]
2024-08-18 HW REV 1.3
    Mains AC safe
    [BOM_FAB-O-MATIC_PCB REV1.3_2024-08-18.xlsx, PickAndPlace_PCB REV1.3_2024-08-18.xlsx, ProPrj_FAB-O-MATIC-rev1.3_2024-08-18.epro]
2024-08-22 Factory reset: overwrite old SavedConfig with default one.
    [main.cpp]
2024-08-25 Added warning for high current with HW REV <1.3
2024-08-25 HW REV 1.3 : added Cu requirement 2oz/ft^2, checked insolation and track width
    delta T = 45°C with I=15A with 2 oz/ft^2
    [BOM_FAB-O-MATIC_PCB REV1.3_2024-08-18.xlsx, PickAndPlace_PCB REV1.3_2024-08-18.xlsx, ProPrj_FAB-O-MATIC-rev1.3_2024-08-18.epro]
2024-11-03 Upgrade to latest tasmota arduino release 3.x
2024-11-23 Upgrade to tasmota esp32 platform release 2024.11.31
2024-12-21 Avoid default In switch Statements
    [BoardLogic.cpp, MockMQTTBroker.cpp]
2026-06-10 Fix MQTT switch off message and clean up const usage
    - Fix Machine::power_mqtt sending the "on" message even when switching off
    - Add virtual destructor to polymorphic MQTTInterface::Response base class
    - Remove const qualifier from by-value return types across the codebase
    - Replace using namespace std::chrono_literals with explicit operator usings
    - Use size_t instead of int for CachedCards indices
    - Return Buzzer& instead of Buzzer* from getBuzzerForTesting
    - Remove unused extern FabBackend declaration in AuthProvider.cpp
    - Remove redundant copy assignment in MachineConfig, make Task instances non-const
    - Recommend pioarduino VS Code extension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
    [AuthProvider.cpp, BoardLogic.cpp, BoardLogic.hpp, BufferedMsg.hpp, CachedCards.hpp, Espressif.cpp, Espressif.hpp, FabUser.hpp]
2026-06-10 Add CLAUDE.md and bump dependencies
    Add CLAUDE.md: guidance for Claude Code (claude.ai/code) including project overview, build/test commands, PlatformIO environments, architecture, configuration, and gotchas to help automated code assistants and contributors. Also update platformio.ini to bump ArduinoJson to v7.4.3 and Adafruit NeoPixel to ^1.15.5.
2026-09-06 Require a password for ArduinoOTA firmware updates
    ArduinoOTA.begin() was called with no setPassword()/setPasswordHash(),
    so any device on the same Wi-Fi as the reader could push an arbitrary
    firmware image over the standard OTA/mDNS protocol (port 3232) with no
    authentication at all, bypassing every RFID/access rule the firmware
    enforces.
    Add secrets::credentials::ota_password (conf/secrets.hpp, following
    the existing ssid/password/mqtt_user pattern) and require it via
    ArduinoOTA.setPassword() before ArduinoOTA.begin(). Existing
    deployments must add ota_password to their conf/secrets.hpp and set
    OTA_PASSWORD in their OTA client to match before their next OTA push.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
2026-09-06 Pin sMQTTBroker to a commit SHA to fix broken wokwi/test builds
    The wokwi env's sMQTTBroker.git@0.1.8 dependency spec was resolving to
    the repo's default-branch HEAD (currently tag 0.1.9's commit) instead
    of the tagged 0.1.8 ref, then failing PlatformIO's version check
    ("Package version 0.1.9+sha.582481b doesn't satisfy requirements
    0.1.8"). This broke every wokwi and test_* build.
    Switch to the #<ref> VCS-pin syntax already used for the other git
    dependencies in this file, pointing at 0.1.8's exact commit SHA
    (2fbba888a9329fcdfdb234c3dd02f17075bfbc75) so it can't drift again.
    Verified: pio run -e wokwi and pio test -e wokwi --without-testing
    --without-uploading -f test_mqtt both build cle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
2026-09-06 Bump GitHub Actions to Node.js 24 runtime versions
    Resolves the "Node.js 20 is deprecated" warnings in CI by moving
    actions/checkout, actions/cache, actions/setup-python,
    actions/upload-artifact, actions/download-artifact and
    actions/github-script to their current majors, all of which run on
    Node 24.
    Claude-Session: https://claude.ai/code/session_01FHW8Hx5SewfDBdCSTYgpiM
2026-09-06 Fix test_logic build: getBuzzerForTesting() returns a reference
    BoardLogic::getBuzzerForTesting() returns Buzzer&, not a pointer, so
    the test was using -> instead of . on its result.
    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
